Columbia-University-ZMBBI-AIC/Teenscience/README.md

# TeenScience
TennScience Platform
TennScience is a hardware and software platform based in Arduino and Teensy 3.6 for science research involving behavioral neuroscience, robotics, sound analysis, and more.
Testing Hardware
