Columbia-University-ZMBBI-AIC/Teenscience/editbrd.pptx

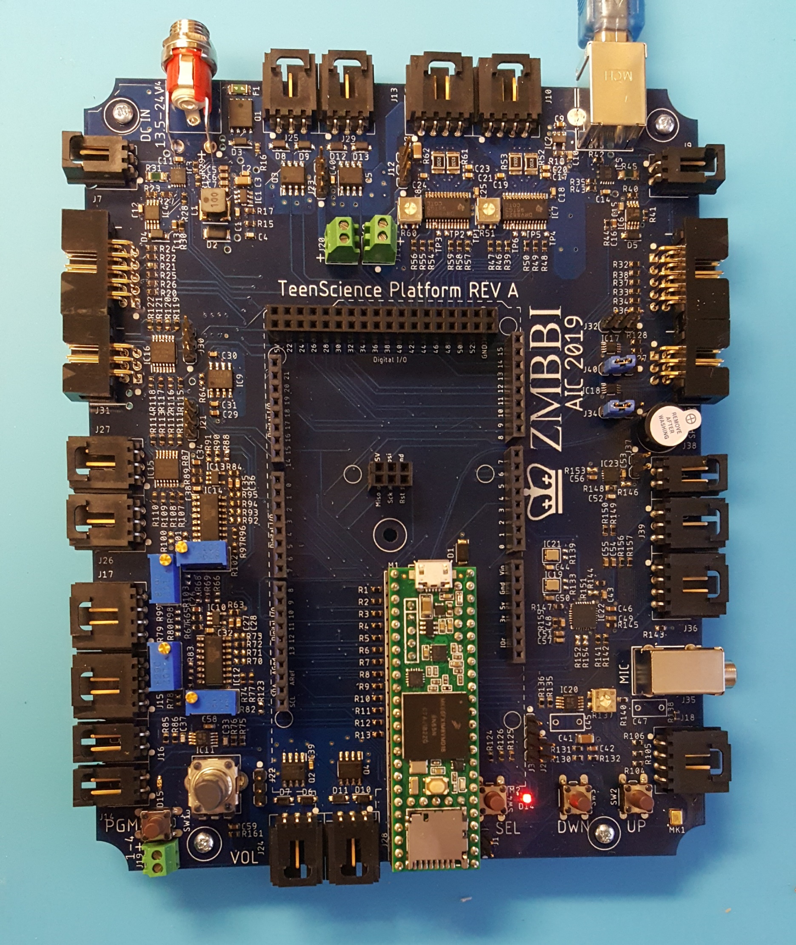
[picture p1: figure]

PWR
J4

GPO
5-6
J25

GPO 5-8
J23

GPO
5-8
J20

GPO
7-8
J29

STPR
LEFT
J13

STPR
J12

STPR
J11

STPR
RIGHT
J10

USB
J5

DC M
LEFT
J7

DC M
RIGHT
J9

ENC
LEFT
J6

GP LEV
J32

ENC
RIGHT
J8

GPIO
J33

S4-SPI
J31

I2C
1
J27

I2C 0/1
J21

SPI LEV
J30

GP I/O
J34

GP I/O
J40

INT.SPK
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
DEB. J3

3.3V J2

TOUCH
J18

DAC
1
J14

POT/VOL

GPO 1-4
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
BATT J1
