Columbia-University-ZMBBI-AIC/Teenscience/Mechanical/TeenSciencePalformPCB-REVB.jpg

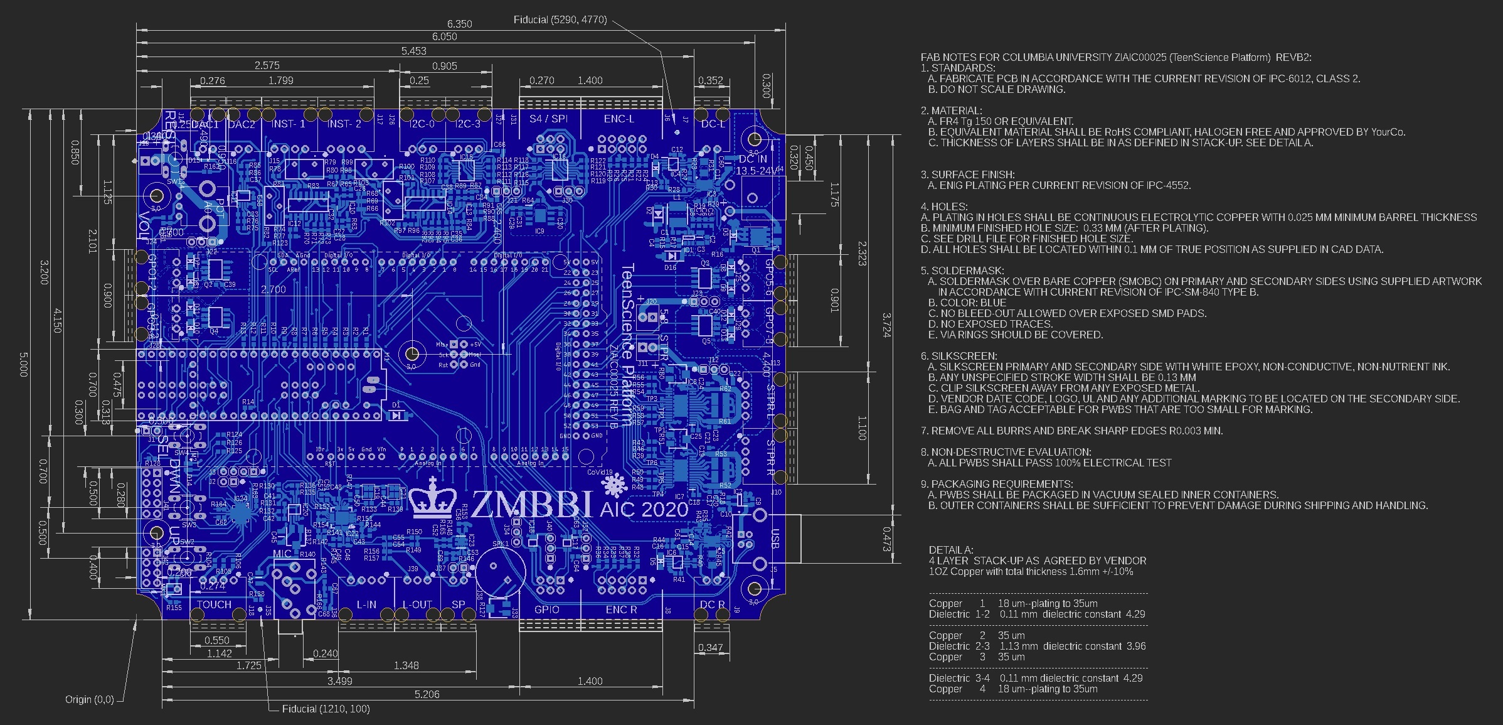
Mechanical/TeenSciencePalformPCB-REVB.jpg
