Columbia-University-ZMBBI-AIC/Teenscience/Hardware/TeenScience-RevB5-SCHB4.BOM.xlsx

 | Columbia University TeenScience Platform ZIAIC00025 REVB4- May 2020 | Rev by R. Hormigo
Qty | DESCRIPTION | Value | Package | Parts | MNF | MPN | VENDOR | Column1
31 | Multilayer Ceramic Capacitor (MLCC)X7R 0603, 0.10uF 5%, 50V | 0.10uF | MLCC_0603 | C1, C2, C11, C12, C14, C15, C17, C19, C20, C21, C23, C24, C28, C30, C31, C32, C36, C38, C39, C40, C43, C44, C48, C53, C58, C62, C63, C64, C65, C66 | AVX | 06035C104JAT2A | Mouser
2 | Multilayer Ceramic Capacitor (MLCC)X7R 0603, 0.010uF 5%, 50V | 0.010uF | MLCC_0603 | C18, C25, C57 | AVX | 06035C103JAT2A | Mouser
6 | Ceramic Capacitor X7R 1206 35V 10uF | 10uF | MLCC_1206 | C3, C22, C45, C47, C60, C61 | TAIYO YUDEN | GMK316AB7106KL-TR
4 | Multilayer Ceramic Capacitor (MLCC)C0G HF 0603, 47pF 1%, 100V | 47pF | MLCC_0603 | C4, C33, C37, C52 | Murata | GCM1885C2A470FA16D | Mouser
15 | Multilayer Ceramic Capacitor (MLCC)X5R 0603, 10uF 10%, 10V | 10uF | MLCC_0603 | C5, C6, C7, C8, C10, C41, C49, C50, C51, C54, C55, C56, C67, C68, C69 | AVX | 0603ZD106KAT2A | Mouser
12 | Multilayer Ceramic Capacitor (MLCC)X7R 0603, 1uF 10%, 35V | 1uF | MLCC_0603 | C9, C13, C16, C26, C27, C29, C34, C35, C42, C46, C59, C70 | TDK | CGA3E1X7R1V105K080AC | Mouser
3 | Nexperia PMEG3030EP,115 SMT Schottky Diode, 30V 3A, 2-Pin SOD128 | PMEG3030 | SOD_128_DIODE | D1, D2, D16 | Nexperia | PMEG3030EP,115
1 | LED DIODE RGB, 5mA, SMT 2X2X0.9mm | RGB | SON95P2X2X1-RGB_LED | D14 | Cree | CLMVC-FKA-CLBDGL7LBB79353 | Mouser
1 | LED DIODE Green, 2mA, 1.9V, SMT 0603 | Green | LED_0603 | D15 | Kingbright | APTD1608LCGCK | Mouser
1 | ZENNER DIODE, 0.5W, 9.1V, SMT SOD123-2 | 9.1V | SOD3716X135N_DIODE | D3 | ON Semi | MMSZ9V1T1G | Mouser
2 | Low forward voltaage Schottky diode | PMEG2010 | SOD-123FL | D4, D5 | Nexperia | PMEG2010ER,115
8 | Rectifier Diode 2A 200V. SOD−123FL | NHP220 | SOD-123FL | D6, D7, D8, D9, D10, D11, D12, D13 | ON Semi | NHP220SFT3G | Mouser
1 | 3A Fast Fuse 1206-3.2X1.6MM | F3A | 1206-3.2X1.6MM | F1 | Schurter | 3413.0121.24
1 | Switching Voltage Regulators DCDC Conv HV Buck TSOT26 | AP63200 | SOT95P280X100-6N | IC1 | Diodes Inc. | AP63200WU-7 | Mouser
2 | 10MHz, IO Rail-to-Rail Op Amp, 12V 2mA max, high current out, SOT-23 | LT1797 | SOT23-5 | IC10, IC13 | LinearTechnologies | LT1797CS5#TRMPBF | Mouser
2 | INA125U, Instrumention Amplifier, 0.25mV Offset, 78dB CMRR, 5V, 16-Pin SOIC | INA125 | SOIC16-127P600X175 | IC12, IC14 | Texas Instruments | INA125U
2 | 4-Bit Bidirectional Multi-Voltage Level Translator for Open-Drain & Push- Pull | LSF0204 | TSSOP14 | IC15, IC16 | Texas Instruments | LSF0204PWR
2 | Texas Instruments SN74LVC2T45DCUR, Voltage Level Translator, Bus Transceiver, 3-State, 1.65 5.5 V, 8-Pin UM | 74LVC2T45 | VSSOP8-DCU-050P | IC17, IC18 | Texas Instruments | SN74LVC2T45DCUR
1 | IC Oscillator 1.6 to 3.6V 50PPM 24.576MHz. 2.5 X 2mm | 24.576MHz | 2.5X2-4-PAD | IC19 | Epson | SG-210STF 24.5760ML3 | Mouser
1 | LTC4411CS8 battery/mains PS controller LTC4411ES5#TRMPBF, Battery Charge Controller, 2600mA, 5-Pin SOT-23 | LTC4411 | SOT95P280X100-5N | IC2 | Linear Technology | LTC4411ES5#TRMPBF
1 | IC Oscillator 1.6 to 3.6V 50PPM 11.2896MHz. 2.5 X 2mm | 11.2896MHz | 2.5X2-4-PAD | IC21 | Epson | SG-210STF 11.2896ML3 | Mouser
1 | Audio Codec 108dB 216KHz 32bit 3.3V with PLL. QFN28 | AK4558EN | QFN-28-5MM-0.5P-PAD | IC22 | AKM | AK4558EN | Digikey
1 | Audio Amplifier ClassAB 1.5W 8Ohm with 4MHz GBP. LFCSP-8 | SSM2211 | LFCSP8_3X3 | IC23 | Analog Devices | SSM2211CPZ-REEL7 | Mouser
1 | Interface - I/O Expanders 16 CHAN LOW VOLT I2C GPIO +PWM | SX1509 | QFN-28-4MM-0.4P-PAD | IC24 | SEMTECH | SX1509BIULTRT
2 | DC Motor H Bridge Driver 4.5 to 36V, 2.5A max SMT TDFN-EP 12 3X3mm | MAX14870 | TDFN12-EP | IC3, IC5 | Maxim | MAX14870ETC+T | Mouser
4 | 36-V, Single-Supply, 10-MHz, Rail-to-Rail Output, Dual Operational Amplifier | TLV2172 | VSSOP8-DGK-065P | IC4, IC6, IC11, IC20 | Texas Instruments | TLV2172IDGKR
2 | 2.5A Bipolar Stepper Motor Driver with On-Chip 1/32 Microstepping Indexer (Step/Dir Ctrl) | DRV8825PWPR | TSSOP28-PWR | IC7, IC8 | Texas Instruments | DRV8825PWPR
1 | ROHM BDJ2FC0WEFJ-E2 LDO HTSOP 8 | BDJ2FC0 | SOIC8-PAD127P600X100 | IC9 | ROHM Semi | BDJ2FC0WEFJ-E2
3 | Header Straight Male 1 X 2 (2.54mm square) 6.75mm post | HDR 1x2 ST-M | HDR_1X2 | J1, J2, J37 | Amphenol FCI | 77311-124-02LF | Mouser
6 | Header RA Male 1X4 Gold Shrouded 0.1" | HDR 1X4 RA-M | HDR_1X4RAS | J10, J13, J15, J17, J18, J36 | Molex | 70555-0073 | Mouser
3 | Phenix Screw terminal 0.1" X 2 | Phoenix 1X2 | TE_282834-2_PHOENIX2 | J11, J19, J20 | TE | 282834-2 | Mouser
8 | Header Straight Male 1 X 3 (2.54mm square) 6.75mm post | HDR 1x3 ST-M | HDR_1X3 | J12, J21, J22, J23, J30, J32, J34, J40 | Amphenol FCI | 77311-124-03LF | Mouser
7 | Header RA Male 1X3 Gold Shrouded 0.1" | HDR 1X3 RA-M | HDR_1X3RAS | J24, J25, J26, J27, J28, J29, J39 | Molex | 70555-0072 | Mouser
1 | Header Straight Male 1 X 4 (2.54mm square) 6.75mm post | HDR 1x4 ST-M | HDR_1X04 | J3 | Amphenol FCI | 77311-124-04LF | Mouser
2 | Header RA Male 2X3 Gold Shrouded 0.1" | HDR 2X3 RA-M | HDR_2X3M_RAS | J31, J33 | 3M | 30306-5002HB | Mouser
1 | Phone Connectors 3.5mm Audio Jack Stereo with Switch | JACK 3.5mm | AUDIO-JACK-SJ1-3533NS | J35 | CUI | SJ1-3535NS
1 | DC Power Jack, Panel Mount, 2.1mm, Standard Bushing, Right Angle PC | 2.1 ID | DCJACK-721RA | J4 | Switchcraft | 721RA
1 | Header Right Angle 2 X 5 (2.54mm square) 5.84 mm mating | HDR 2x5 RA-M | HDR_2X5M_RAHDR | J41 | SAMTEC | TSW-104-10-G-D-RA | Mouser
1 | Header Right Angle 2 X 4 (2.54mm square) 5.84 mm mating | HDR 2x4 RA-M | HDR_2X4M_RAHDR | J42 | SAMTEC | TSW-104-08-G-D-RA | Mouser
1 | USB B STANDARD RA, TH | USB-B-RA | USB-B | J5 | MOLEX | 67068-8000 | Mouser
2 | Header RA Male 2X5 Gold Shrouded 0.1" | HDR 2X5 RA-M | HDR_2X5M_RAS | J6, J8 | 3M | 30310-5002HB | Mouser
5 | Header RA Male 1X2 Gold Shrouded 0.1" | HDR 1X2 RA-M | HDR_1X2RAS | J7, J9, J14, J16, J38 | Molex | 70555-0071 | Mouser
1 | TDK VLS-EX Series Type 5045 Shielded Wire-wound SMD Inductor with a Ferrite Core, 10 uH Wire-Wound 2.5A Idc | 10uH | IND_5X5MM-5045 | L1 | TDK | VLS5045EX-100M
1 | Teensy 3.6, 3.3V, 180MHz controller with no pins | Teensy 3.6 | TEENSY_3.6 | M1 | PJRC | TEENSY36 (No pins) | Sparkfun
1 | Teensy 3.5/3.6 Socket Kit | Connector Kit | See datasheet directions | M1 (Pins) | Tall Dog Electronics | Teensy 3.5/3.6 Socket Kit | Tindie.com | https://d3s5r33r268y59.cloudfront.net/datasheets/8746/2017-02-08-07-39-59/Teensy_3.5_3.6_Socket_Kit_Datasheet.pdf
1 | Wideband 80KHz MEMS 2.65X3.5mm MIC 400Ohm 145uA 1.5-3.6V | MIC | SPH6611_MEMS_2.65X3.50 | MK1 | KnowLess | SPH6611LR5H-1 | Mouser
1 | P CH MOSFET 40V, 100A, 1.4mOhm, SMT DFN 8 5.1x6.3 | FDWS9509L | FDN8_5.1X6.3 | Q1 | ON Semi | FDWS9509L-F085 | Mouser
4 | Diodes Inc DMG4822SSDQ-13 Dual N-channel MOSFET Transistor, 10 A, 30 V, 8-Pin SOP | DMG4822 | SOIC8-127P60 | Q2, Q3, Q4, Q5 | Diodes Inc. | DMG4822SSDQ-13
19 | Thick Film Resistor 0603, 20 Ω ,1%, 0.1W | 20 Ω | R0603 | R1, R2, R3, R4, R5, R6, R7, R8, R9, R10, R11, R12, R13, R14, R63, R84, R144, R145, R161 | Vishay | CRCW060320R0FKEA | Mouser
7 | Thick Film Resistor 0603, 1.0 kΩ ,1%, 0.1W | 1.0 kΩ | R0603 | R104, R105, R106, R111, R112, R113, R114 | Vishay | CRCW06031K00FKEA | Mouser
2 | Thick Film Resistor 0603, 360 Ω ,1%, 0.1W | 360 Ω | R0603 | R123, R124 | Vishay | CRCW0603360RFKEA | Mouser
5 | Thick Film Resistor 0603, 100 Ω ,1%, 0.1W | 100 Ω | R0603 | R125, R126, R138, R156, R157 | Vishay | CRCW0603100RFKEA | Mouser
1 | SM Single turn Top Screw Trimmer 1K | 1K | SM-4.5X4.5-TRIM | R127 | BOURNS | 3314J-2-102E
11 | 0603 Resistor Shunt (no part placed) | SHUNT | R0603-SHORT | R129, R146, R151, R152, R153, R154, R158, R159, R160, R163, R164
1 | Audio single pot. 10K Vertical 20mm,1B Alps Potentiometer RK09D Series with a 6 mm Dia. Shaft 10k +/-20% 0.05W, Linear, Through Hole | 10K | RK09-ALPS-VERT-POT | R134 | ALPS | RK09D1130C1B
1 | SM Single turn Top Screw Trimmer 200K | 200K | SM-4.5X4.5-TRIM | R137 | BOURNS | 3314J-2-204E
1 | Thick Film Resistor 0603, 56 kΩ ,1%, 0.1W | 56 kΩ | R0603 | R15 | Vishay | CRCW060356K0FKEA | Mouser
1 | Thick Film Resistor 0603, 100 kΩ ,1%, 0.1W | 100 kΩ | R0603 | R16 | Vishay | CRCW0603100KFKEA | Mouser
44 | Thick Film Resistor 0603, 10 kΩ ,1%, 0.1W | 10 kΩ | R0603 | R17, R19, R27, R28, R29, R30, R35, R39, R41, R42, R43, R44, R47, R48, R49, R50, R54, R56, R57, R58, R59, R67, R76, R86, R89, R107, R108, R109, R110, R115, R116, R117, R118, R119, R120, R121, R122, R128, R131, R132, R140, R149, R150, R162 | Vishay | CRCW060310K0FKEA | Mouser
1 | Thick Film Resistor 0603, 470 kΩ ,1%, 0.1W | 470 kΩ | R0603 | R18 | Vishay | CRCW0603470KFKEA | Mouser
10 | Thick Film Resistor 0603, 2.2 kΩ ,1%, 0.1W | 2.2 kΩ | R0603 | R20, R21, R22, R32, R33, R34, R74, R96, R143, R166 | Vishay | CRCW06032K20FKEA | Mouser
3 | Thick Film Resistor 0603, 300 kΩ ,1%, 0.1W | 300 kΩ | R0603 | R23, R40, R135 | Vishay | CRCW0603300KFKEA | Mouser
8 | Thick Film Resistor 0603, 4.3 kΩ ,1%, 0.1W | 4.3 kΩ | R0603 | R24, R25, R26, R36, R37, R38, R65, R136 | Vishay | CRCW06034K30FKEA | Mouser
2 |  | 0.025 Ohm | R1206 | R31, R45 | KOA | UR73VD2BTTD25L0F
11 | Thick Film Resistor 0603, 0 Ω ,1%, 0.1W | 0 Ω | R0603 | R46, R55, R68, R69, R72, R94, R130, R141, R142, R147, R155 | Vishay | CRCW06030000Z0EA | Mouser
2 | SM Single turn Top Screw Trimmer 10K | 10K | SM-4.5X4.5-TRIM | R51, R60 | BOURNS | 3314J-2-103E
4 |  | 0.1 Ohm | R1210 | R52, R53, R61, R62 | Vishay | RCWE1210R100FKEA
21 | No Placed/Populated Resistor | NP | R0603 | R64, R66, R70, R71, R73, R77, R78, R80, R83, R88, R90, R91, R92, R93, R95, R97, R98, R100, R103, R133, R139
2 | Thick Film Resistor 0603, 3.9 kΩ ,1%, 0.1W | 3.9 kΩ | R0603 | R75, R85 | Vishay | CRCW06033K90FKEA | Mouser
4 | Thru Hole Multiturn Top ScrewTrimmer | 1K | PV36YTRIMMER | R79, R82, R99, R102 | Bourns | PV36Y102C01B00
2 | Thick Film Resistor 0603, 51 Ω ,1%, 0.1W | 51 Ω | R0603 | R81, R101 | Vishay | CRCW060351R0FKEA | Mouser
3 | Thick Film Resistor 0603, 15 kΩ ,1%, 0.1W | 15 kΩ | R0603 | R87, R148, R165 | Vishay | CRCW060315K0FKEA | Mouser
1 | Piezo Transducer 5mm Pitch 12.4mm Diameter. 2KHz Resonance, 5v Nom,30V max | CMI-9650C-120 | BUZZER-5MM-12.4D | SPK1 | DB LIMITED | TP124005-2
4 | Momentary Switch 6mm SPST 100mOhm Max 50ma 12V | SPST | SWITCH_TAC_6MM | SW1, SW2, SW3, SW4 | Diptronics | DTS-65N-V | Mouser
2 | 24.5x3mm | LED Light Pipes LFB 3mm LightPipe 1.000" Length | EXTERNAL | LP1, LP2 | VCC | LFB100CTP | Mouser
