Columbia-University-ZMBBI-AIC/Teenscience/TeenScienceRAVA0-SignalsReleased.xlsx

TeenScience REV A Hardware platform pinouts and signals for Teensy 3.6
Description | TeenScience Connector-Pin | TeenScience | Teensy Pin Used | Other Teensy Functionality | Settings
Ext. Battery | J1-1 | GND | GND | GND
 | J1-2 | VBATT |  | VBATT
V3.3V | J2-1 | GND | GND | GND
 | J2-2 | 3.3V OUT |  | 3.3V OUT
Debug Port | J3-1 |  |  | Debug Reset
 | J3-2 |  |  | DC
 | J3-3 |  |  | DD
 | J3-4 |  |  | DE
DC Power IN VPWR 13.5-24V | J4-Center | DC VPWR
 | J4-Shield | GND | GND | GND
USB IF | J5-1 | USB RAW 5V
 | J5-2 | USB+ |  | USB+
 | J5-3 | USB- |  | USB-
 | J5-4 | GND | GND | GND
 | J5-Shield | GND | GND | GND
Encoder Left | J6-1 | NC
 | J6-2 | +5V
 | J6-3 | GND | GND
 | J6-4 | NC
 | J6-5 | NC
 | J6-6 | CHA-L | D3 (I) | SCL-2/CAN0TX/PWM
 | J6-7 | NC
 | J6-8 | CHB-L | D4 (I) | SDA-2/CAN0RX/PWM
 | J6-9 | NC
 | J6-10 | CHI-L | D2 (I) | PWM
DC Motor Left | J7-1 | M1-L | D26 - ~FAULT (I) D7 - DIR (O) D5 - PWM (O) D24 - ~EN (O) A14 - CURRENT(O) | RX3/PWM PWM D33/CAN1TX/TX5
 | J7-2 | M2-L
Encoder Right | J8-1 | NC
 | J8-2 | +5V
 | J8-3 | GND | GND
 | J8-4 | NC
 | J8-5 | NC
 | J8-6 | CHA-R | D29 (I) | Touch@29/PWM
 | J8-7 | NC
 | J8-8 | CHB-R | D30 (I) | Touch@30/PWM
 | J8-9 | NC
 | J8-10 | CHI-R | D28 (I)
DC Motor Right | J9-1 | M1-R | D27 - ~FAULT (I) D8 - DIR (O) D6 - PWM (O) D25 - ~EN (O) A15 - CURRENT(O) | TX3/PWM PWM D34/CAN1RX/RX5
 | J9-2 | M2-R
Stepper PWR (EXT PWR for Steppers) | J11-1 | GND |  |  | Use J12 to select either EXT PWR@J11 (1-2) or internal VPWR (2-3) for steppers
 | J11-2 | EXT PWR
Stepper Right | J10-1 | B1-R | D49 - DIR (O) D50 - STEP (O) D48 - ~FAULT/~SLEEP (I/O) D47 - ~RESET (O) D53 - MODE2 (I) D52 - MODE1 (I) D51 - MODE0 (I) | A23 A24 TX6 RX6 Shared with Left Shared with Left Shared with Left
 | J10-2 | B2-R
 | J10-3 | A1-R
 | J10-4 | A2-R
Stepper Left | J13-1 | B1-L | D45 - DIR (O) D46 - STEP (O) D44 - ~FAULT/~SLEEP (I/O) D43 - ~RESET (O) D53 - MODE2 (I) D52 - MODE1 (I) D51 - MODE0 (I) | MISO2 SCK2 MOSI2 CS2 Shared with Right Shared with Right Shared with Right
 | J13-2 | B2-L
 | J13-3 | A1-L
 | J13-4 | A2-L
DAC 1 | J14-1 | AGND | AGND | GND
 | J14-2 | DAC1 | DAC0 | A21
Inst. Amp. 1 | J15-1 | VREF1 (AGND) | A6 AGND | D20 PWM CS0 GND
 | J15-2 | -VIN1
 | J15-3 | +VIN1
 | J15-4 | VREF1 (O)
DAC 2 | J16-1 | AGND | AGND | GND
 | J16-2 | DAC1 | DAC0 | A21
Inst. Amp. 2 | J17-1 | VREF2 (AGND) | A6 AGND | D20 PWM CS0 GND
 | J17-2 | -VIN2
 | J17-3 | +VIN2
 | J17-4 | VREF2 (O)
Touch Interface | J18-1 | AGND | GND | GND
 | J18-2 | TOUCH1/UP_SW | Touch@17 | A3/PWN
 | J18-3 | TOUCH2 | Touch@16 | A2/PWM
 | J18-4 | TOUCH3 | Touch@15 | A1/CS0
GPO 1-4 PWR (EXT PWR for GPOs) | J19-1 | GND |  |  | Use J22 to select either EXT PWR@J19 (1-2) or internal VPWR (2-3) for GPO 1-4
 | J19-2 | EXT PWR 1-4
GPO 1-2 | J24-1 | GPO 1 | D35 | A16/PWM
 | J24-2 | PWR 1-4
 | J24-3 | GPO 2 | D36 | A17/PWM
GPO 3-4 | J28-1 | GPO 3 | D39 | A20
 | J28-2 | PWR 1-4
 | J28-3 | GPO 4 | D40
GPO 5-8 PWR (EXT PWR for GPOs) | J20-1 | GND |  |  | Use J23 to select either EXT PWR@J20 (1-2) or internal VPWR (2-3) for GPO 5-8
 | J20-2 | EXT PWR 5-8
GPO 5-6 | J24-1 | GPO 5 | D37 | A18/PWM/SCL1
 | J24-2 | PWR 5-8
 | J24-3 | GPO 6 | D38 | A19/PWM/SDA1
GPO 7-8 | J28-1 | GPO 7 | D41
 | J28-2 | PWR 5-8
 | J28-3 | GPO 8 | D42
GPIO/BUZZER | J33-1 | INT. BUZZER+/GPIO10 | D10 (I/O) | CS0/TX2 | Use J32 to select either +5V (1-2) or 3.3V (2-3) level for all J33 levels
 | J33-2 | INT. BUZZER-/GPIO12 | D12 (I/O) | MISO0
 | J33-3 | EXT. BUZZER+/GPIO54 | D54 (I/O) | CS2 | Use J34 to select GPIO direction In(1-2) or Out (2-3) for GPIO10 and GPIO12
 | J33-4 | EXT. BUZZER-/GPIO55 | D55 (I/O)
 | J33-5 | REF PWR |  |  | Use J36 to select either +5V (1-2) or 3.3V (2-3) level for GPIO54 and GPIO55
 | J33-6 | GND | GND
I2C-0 (Main I2C) | J26-1 | GND | GND | GND | Use J21 to select either +5V (1-2) or 3.3V (2-3) level for I2C-0
 | J26-2 | SDA | SDA0 | 19/A5/Touch
 | J26-3 | SCL | SCL0 | 18/A4/Touch
I2C-3 (I2C 3) | J27-1 | GND | GND | GND | Use J21 to select either +5V (1-2) or 3.3V (2-3) level for I2C-0
 | J27-2 | SDA3 | SDA3 | 57
 | J27-3 | SCL3 | SCL3 | 56
SPI-1 /Serial 4 | J31-1 | MISO 1 | MISO1 | D1
 | J31-2 | SPI-PWR |  |  | Use J30 to select either +5V (1-2) or 3.3V (2-3) level for SPI-1
 | J31-3 | SCK 1/TX4 | SCK1/TX4 | D32/A13
 | J31-4 | MOSI 1 | MOSI1 | D0
 | J31-5 | CS 1/RX4 | CS1/RX4 | D31/A12
 | J31-6 | GND | GND | GND
EXT. MIC | J35-TIP | MIC-IN | I2S-MCK I2S-BCK I2S-LRCK I2S-SDO I2S-SDI SCL SDA | D11/MOSI0 D9/RX2/CS0 D23/A9/PWM/Touch D22/A8/PWM/Touch D13/SCK0/LED D19/A5/SCL0/Touch D18/A4/SDA0/Touch | All Audio Ports share the same I2S interface and I2C 0 The I2S can be set via I2C 0 to master or slave. In master the MCK can be set by placing resistors at R133 or R139 for whatever samplings are needed
 | J35-RING | 5V BIAS
 | J35-SHIELD | GND
LINE IN | J36-1 | 3.3V OUT
 | J36-2 | GND
 | J36-3 | Line Left In
 | J36-4 | Line Right In
AMP OUT | J37-1/J38-1 | AMP-
 | J37-2/J38-2 | AMP+
LINE OUT | J39-1 | Line Left Out
 | J39-2 | GND
 | J39-3 | Line Left In
