Columbia-University-ZMBBI-AIC/Teenscience/Mechanical/potM.stl

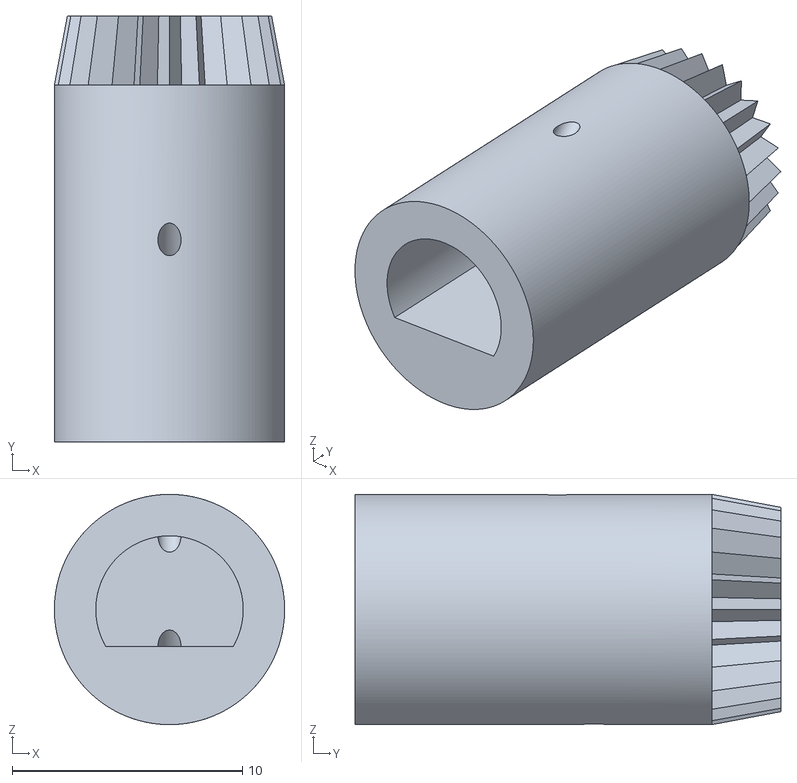
[picture p3: CAD file, 2023-01-09]
Mechanical/potM.stl
10.0 x 18.5 x 10.00
