Columbia-University-ZMBBI-AIC/Teenscience/Mechanical/ButtonPGMTeenScienceM.stl

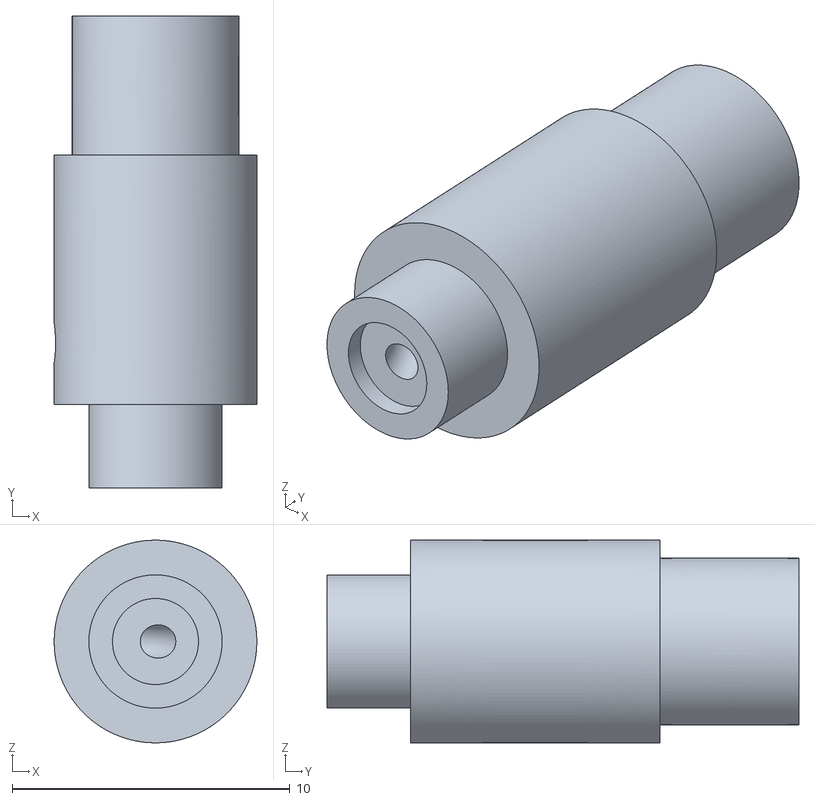
[picture p4: CAD file, 2023-01-09]
Mechanical/ButtonPGMTeenScienceM.stl
7.30 x 17.0 x 7.30
