Columbia-University-ZMBBI-AIC/Teenscience/Mechanical/buttonTeenScienceM.stl

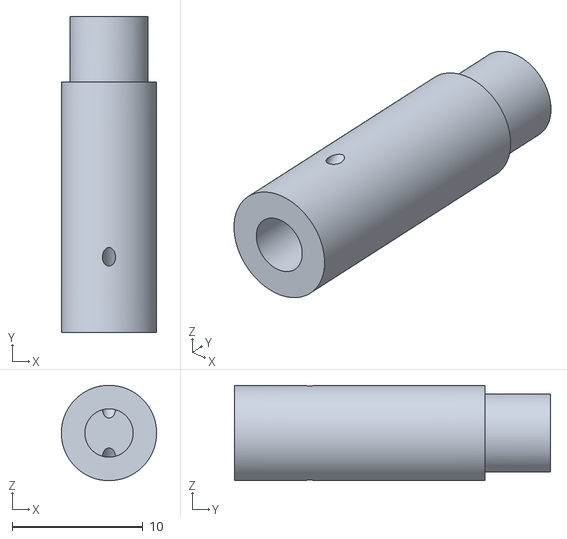
[picture p5: CAD file, 2023-01-09]
Mechanical/buttonTeenScienceM.stl
7.30 x 24.2 x 7.30
