Columbia-University-ZMBBI-AIC/Teenscience/Hardware/TeenScience-RevB2.pdf

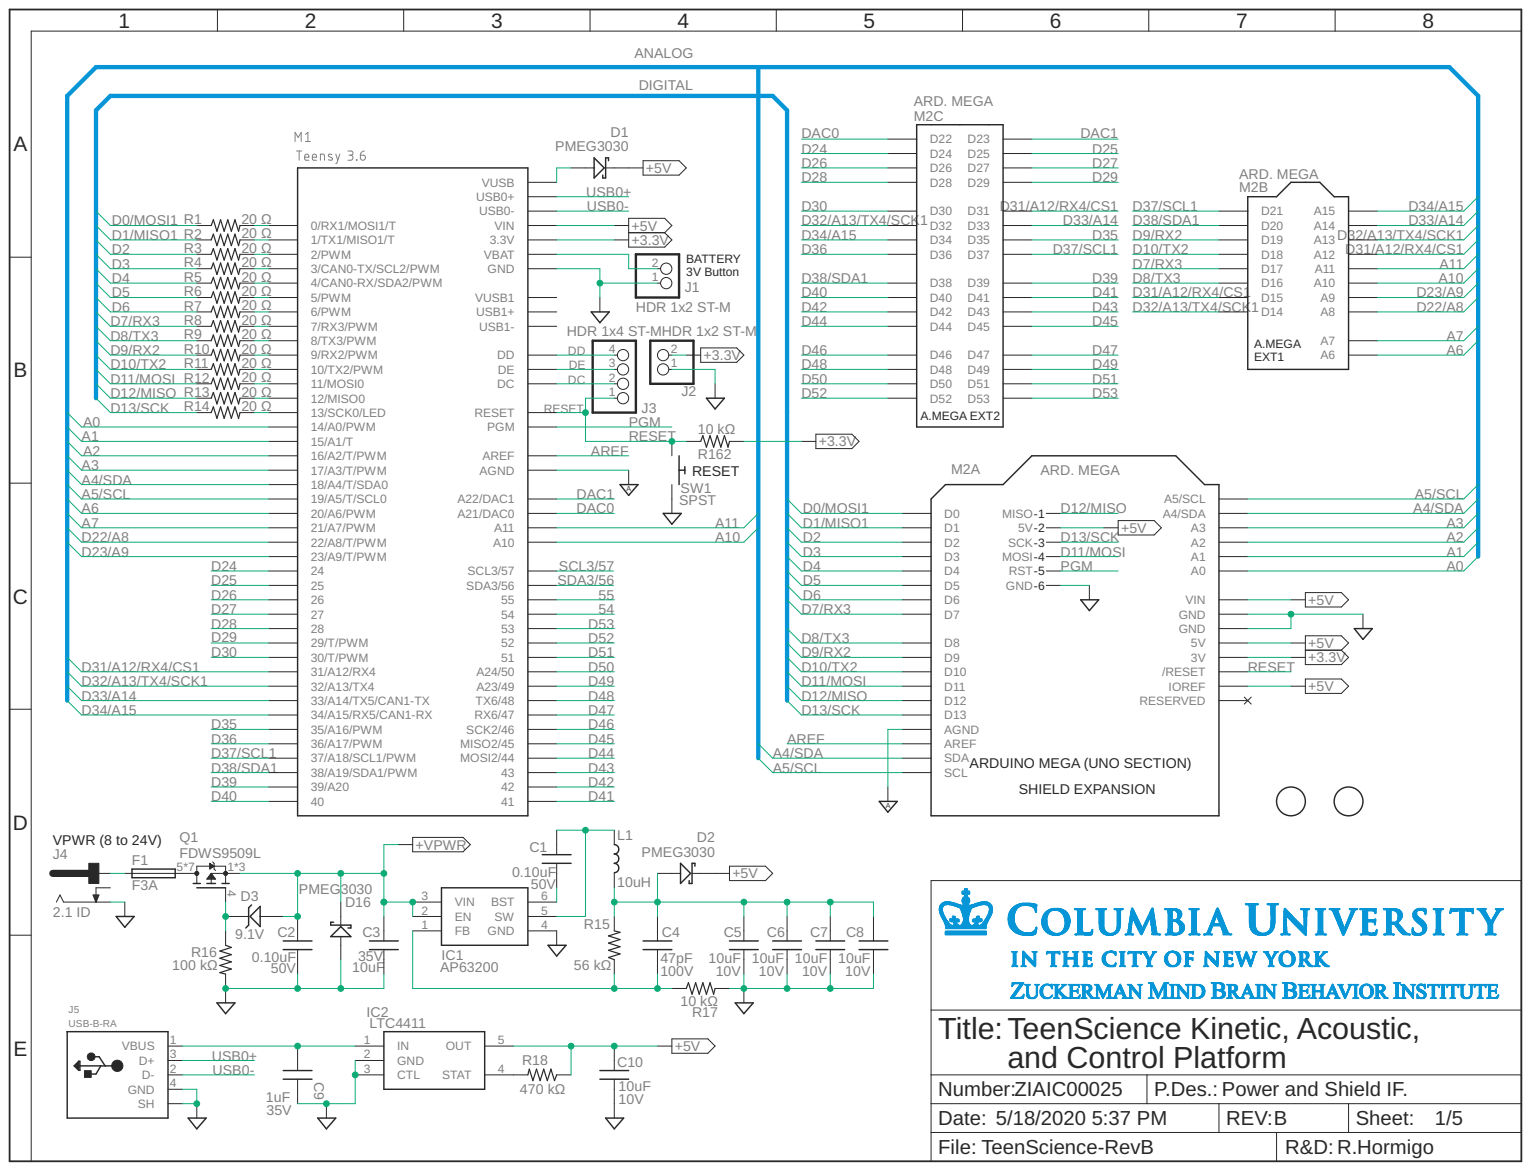
[picture p6: page 1]

ANALOG

HDR 1x4 ST-MHDR 1x2 ST-M
DEDD AREF

TeenScience Kinetic, Acoustic, and Control Platform

Number: ZIAIC00025 | P.Des.:
Date: 5/18/2020 5:37 PM | REV: B | Sheet: 1/5
File: TeenScience-RevB | R&D:

Power and Shield IF. R.Hormigo

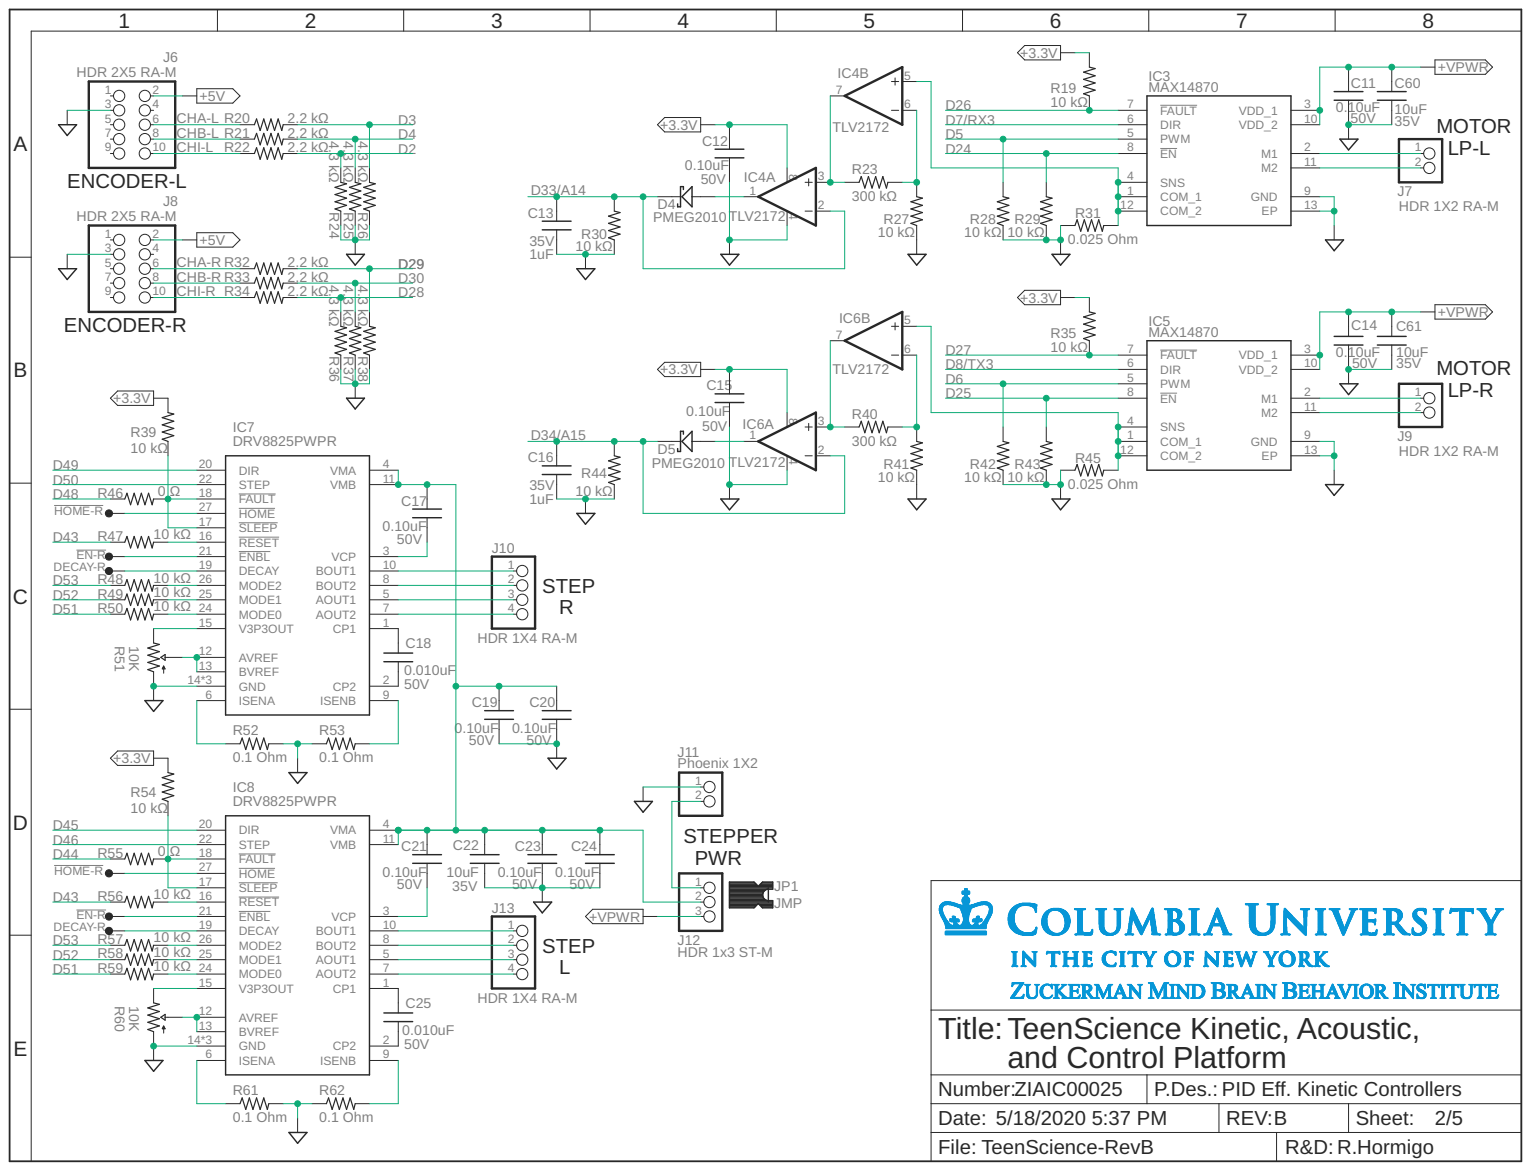
[picture p7: page 2]

TeenScience Kinetic, Acoustic, and Control Platform

PID Eff. Kinetic Controllers

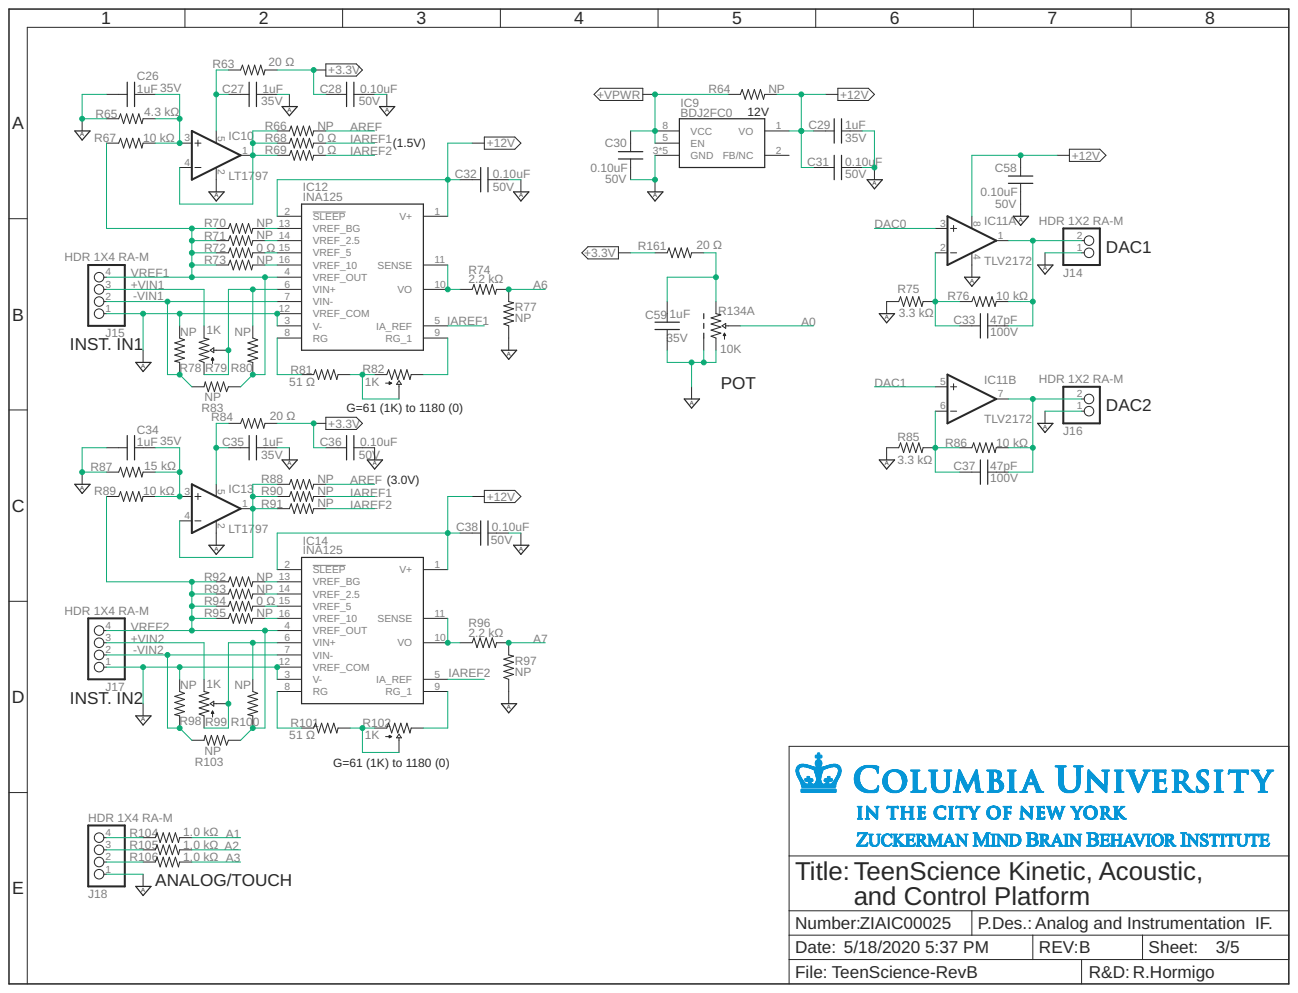
[picture p8: page 3]

TeenScience Kinetic, Acoustic, and Control Platform

Analog and Instrumentation IF. R.Hormigo

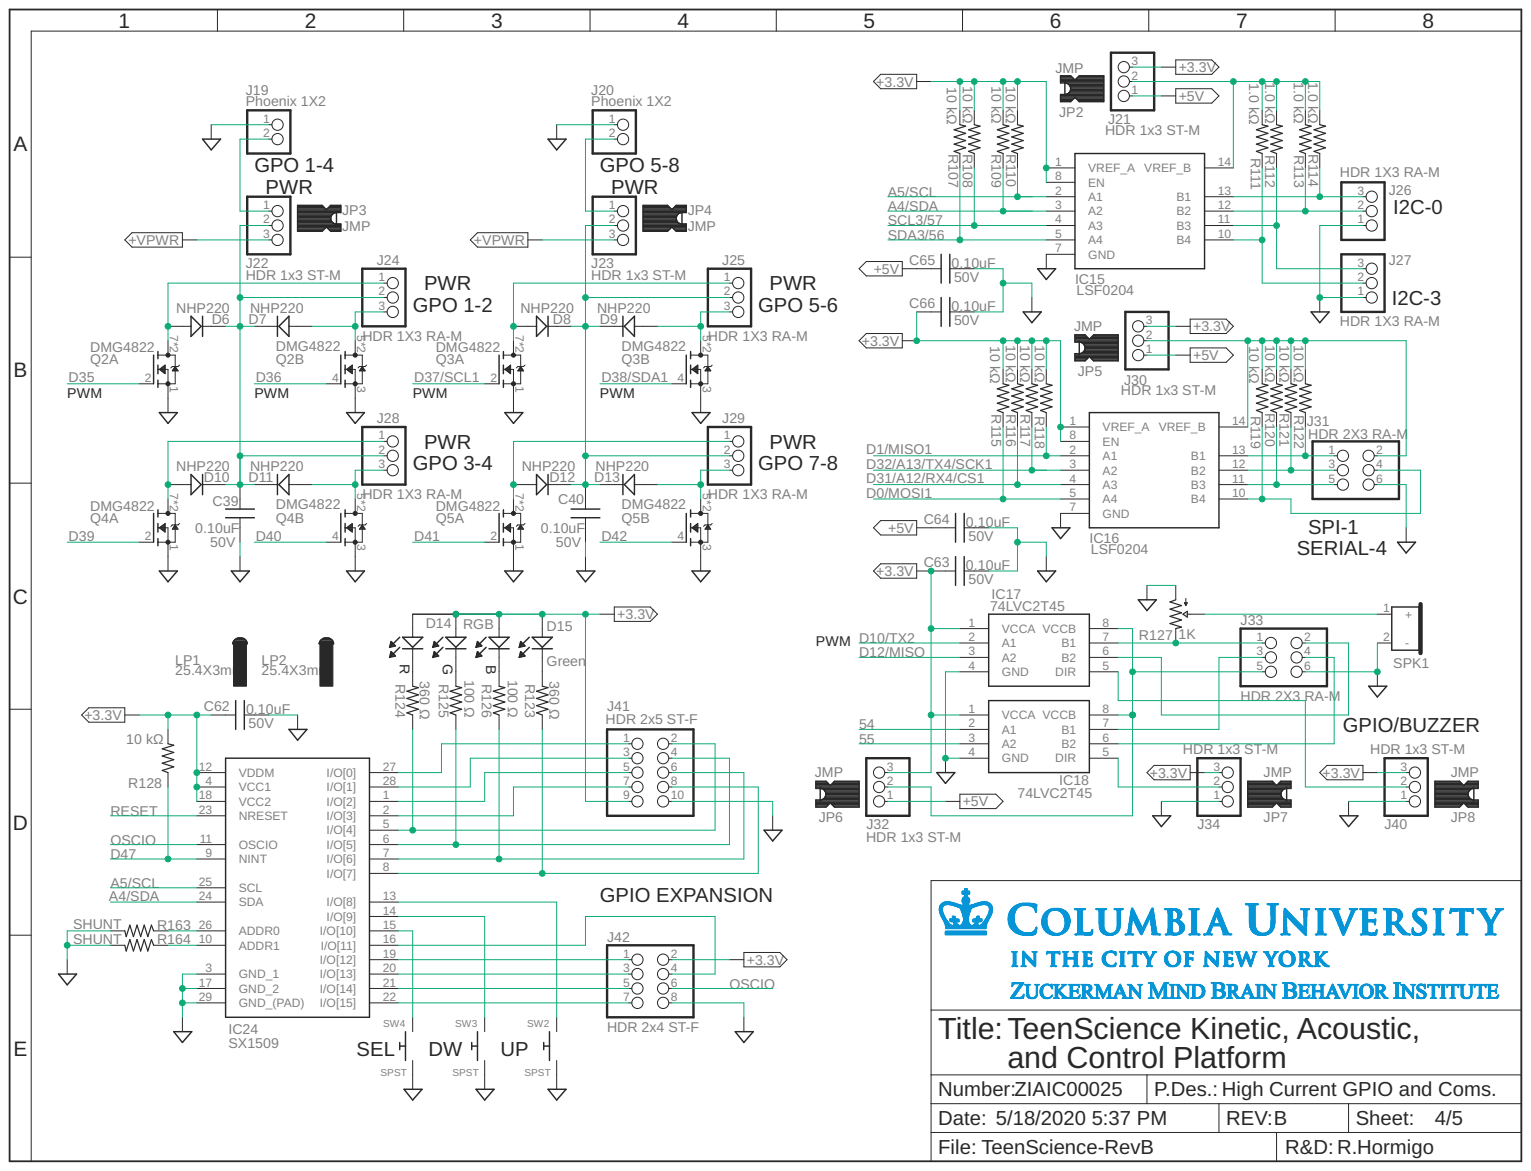
[picture p9: page 4]

TeenScience Kinetic, Acoustic, and Control Platform

High Current GPIO and Coms. R.Hormigo

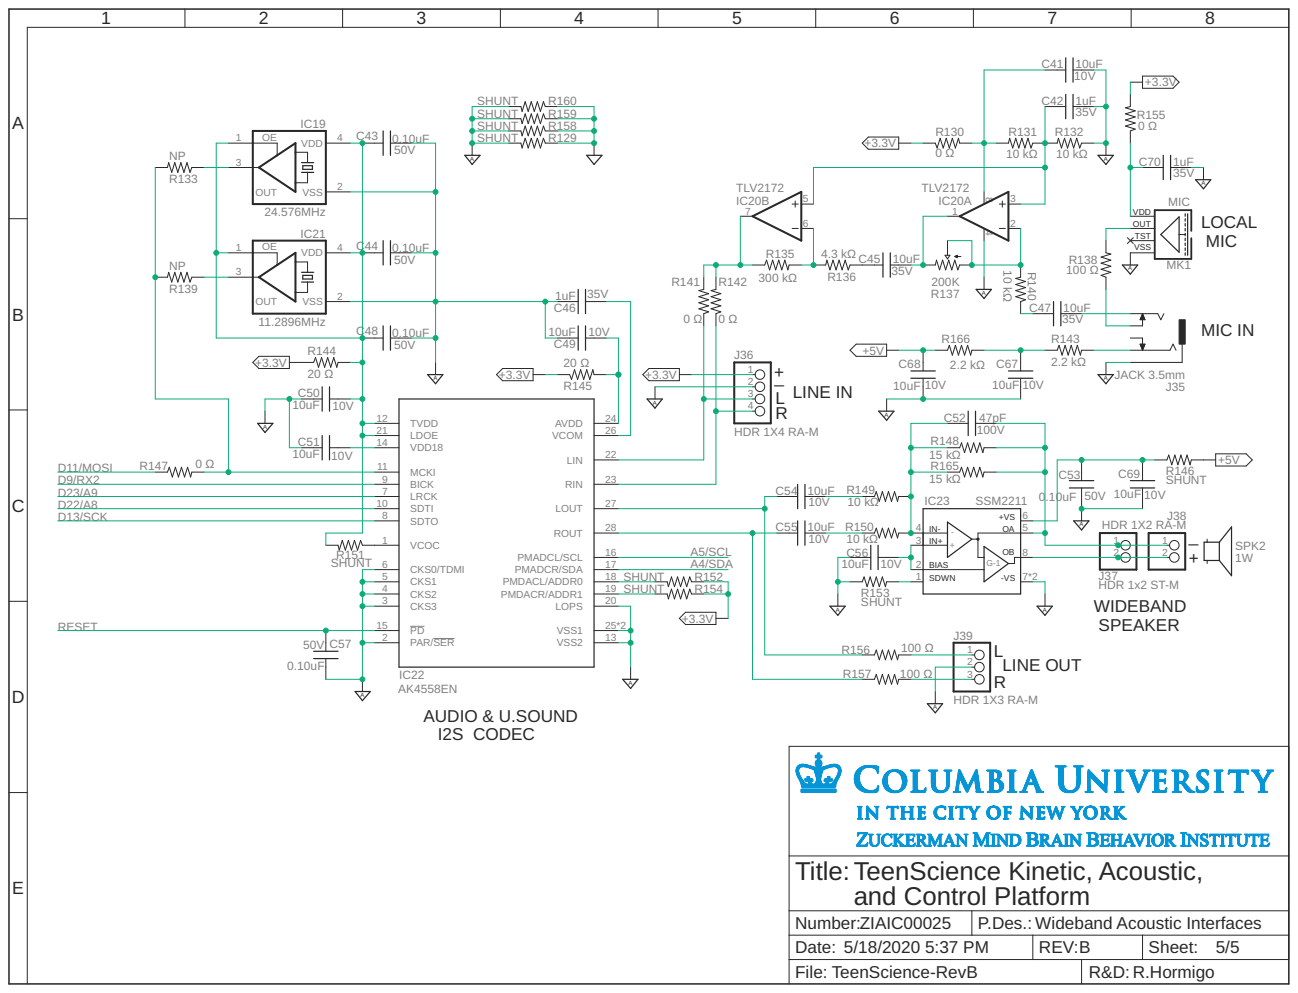
[picture p10: page 5]

TeenScience Kinetic, Acoustic, and Control Platform
