Columbia-University-ZMBBI-AIC/Teenscience/Mechanical/enclosure.pdf

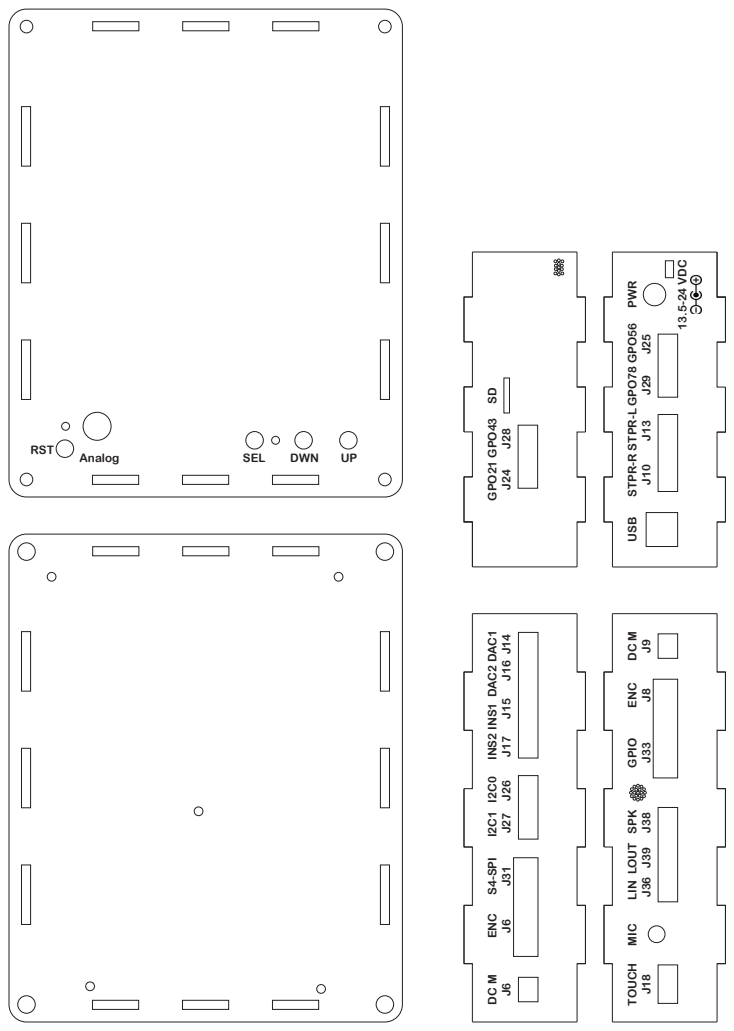
[picture p12: page 1]
