Columbia-University-ZMBBI-AIC/Teenscience/Mechanical/PCB Dim TeenScienceREVA.pdf

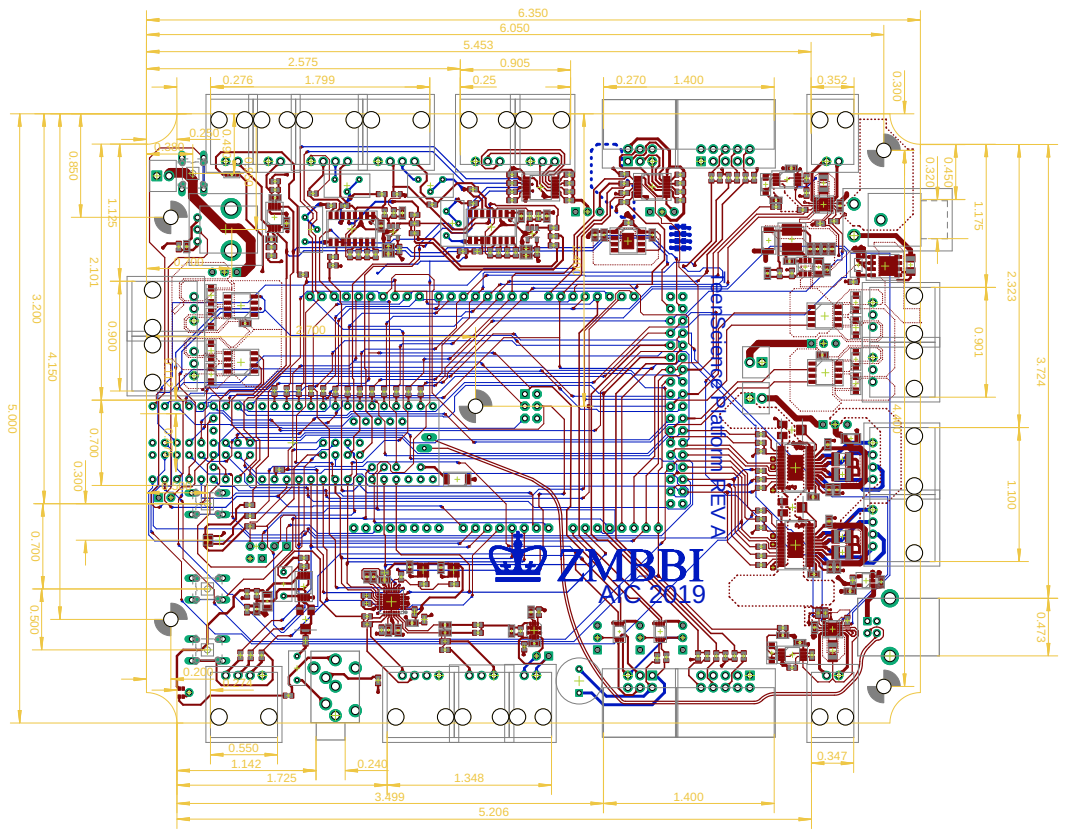
[picture p13: page 1]
