Columbia-University-ZMBBI-AIC/Teenscience/Hardware/TeenScience-RevB3.brd

## EAGLE design Hardware/TeenScience-RevB3.brd (2023-01-09)

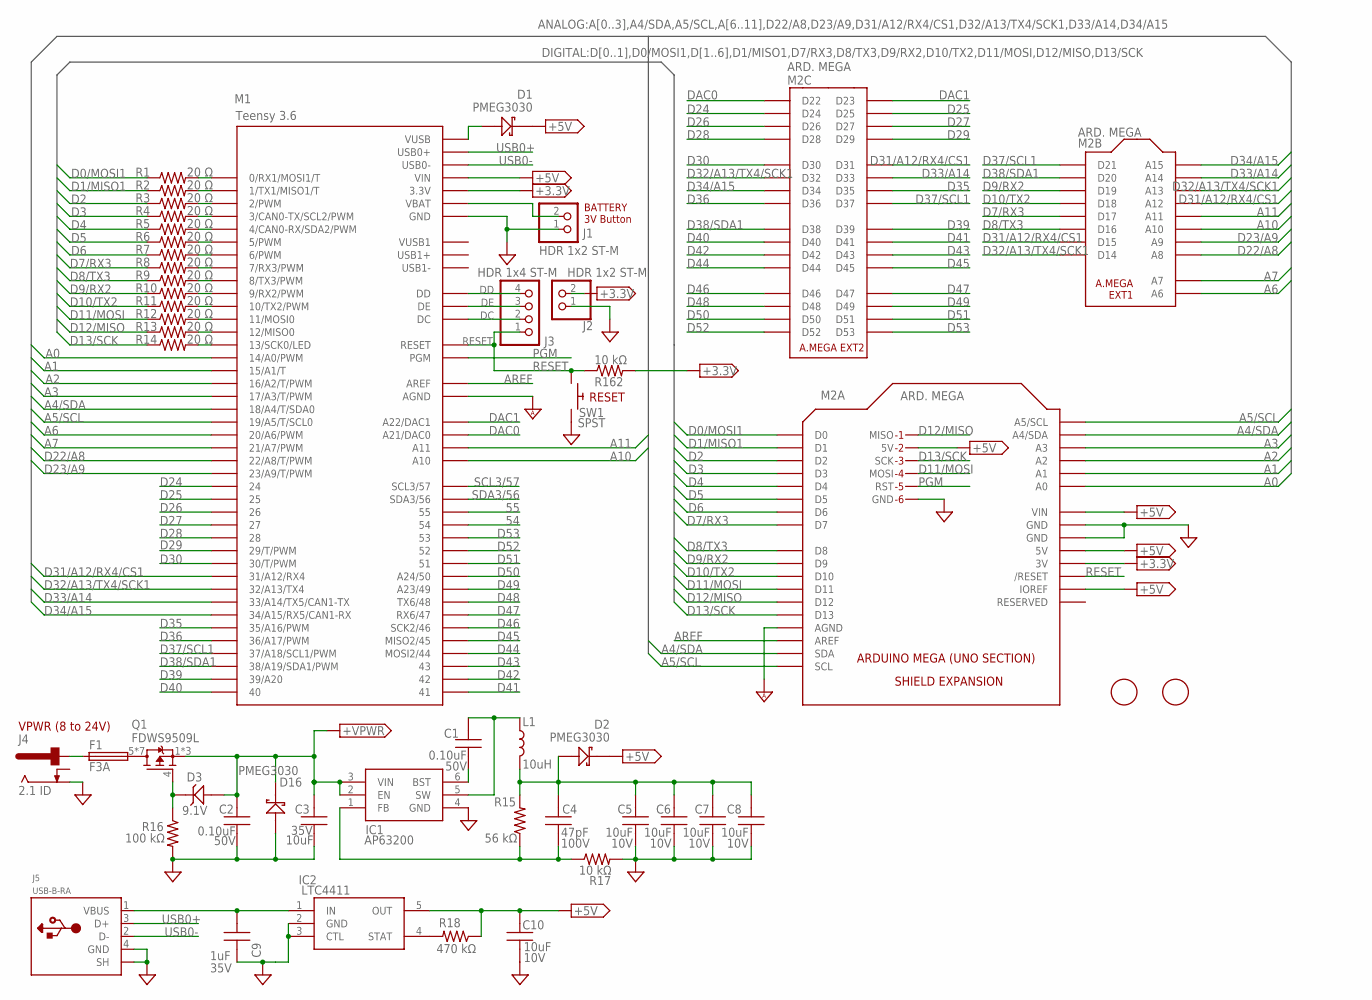
[picture p14: schematic TeenScience-RevB3.sch, sheet 1]

Parts:
C1, C2: 0.10uF; MLCC_0603
C3: 10uF; MLCC_1206
C4: 47pF; MLCC_0603
C5, C6, C7, C8, C10: 10uF; MLCC_0603
C9: 1uF; MLCC_0603
D1, D2, D16: PMEG3030; SOD_128_DIODE
D3: 9.1V; SOD3716X135N_DIODE
F1: F3A; 1206-3.2X1.6MM
IC1: AP63200; SOT95P280X100-6N
IC2: LTC4411; SOT95P280X100-5N
J1, J2: HDR 1x2 ST-M; HDR_1X2
J3: HDR 1x4 ST-M; HDR_1X04
J4: 2.1 ID; DCJACK-721RA
J5: USB-B-RA; USB-B
L1: 10uH; IND_5X5MM-5045
M1: Teensy 3.6; TEENSY_3.6_ALL_PINS&PADS
M2: ARD. MEGA; ARDUINO_MEGA_ICSP
Q1: FDWS9509L; FDN8_5.1X6.3
R1, R2, R3, R4, R5, R6, R7, R8, R9, R10, R11, R12, R13, R14: 20 Ω; R0603
R15: 56 kΩ; R0603
R16: 100 kΩ; R0603
R17, R162: 10 kΩ; R0603
R18: 470 kΩ; R0603
SW1: SPST; SWITCH_TAC_6MM
U$3, U$6: FIDUCIAL; FIDUCIAL_1MM

Connections:
54: M1.54; also elsewhere on the board
55: M1.55; also elsewhere on the board
+3.3V: J2.2, M1.3.3V, M1.3.3V2 (3.3V), M1.3.3V3 (3.3V), M1.3.3V4 (3.3V), M2.3V, R162.2; also elsewhere on the board
+5V: C10.2, D1.1 (K), D2.1 (K), IC2.5 (OUT), M1.VIN, M2.5V, M2.5V@1 (5V), M2.5V@2 (5V), M2.5V_ICSP (5V), M2.IOREF, M2.VIN, R18.1; also elsewhere on the board
+VPWR: C2.1, C3.1, D3.2 (A), D16.1 (K), IC1.2 (EN), IC1.3 (VIN), Q1.1 (S), Q1.2 (S), Q1.3 (S); also elsewhere on the board
A0: M1.14/A0 (14/A0/PWM), M2.A0; also elsewhere on the board
A1: M1.15/A1 (15/A1/T), M2.A1; also elsewhere on the board
A2: M1.16/A2 (16/A2/T/PWM), M2.A2; also elsewhere on the board
A3: M1.17/A3 (17/A3/T/PWM), M2.A3; also elsewhere on the board
A4/SDA: M1.18/A4 (18/A4/T/SDA0), M2.A4 (A4/SDA), M2.SDA; also elsewhere on the board
A5/SCL: M1.19/A5 (19/A5/T/SCL0), M2.A5 (A5/SCL), M2.SCL; also elsewhere on the board
A6: M1.20/A6 (20/A6/PWM), M2.A6; also elsewhere on the board
A7: M1.21/A7 (21/A7/PWM), M2.A7; also elsewhere on the board
A10: M1.A10, M2.A10
A11: M1.A11, M2.A11
AREF: M1.AREF, M2.AREF; also elsewhere on the board
D0/MOSI1: M2.D0, R1.1; also elsewhere on the board
D1/MISO1: M2.D1, R2.1; also elsewhere on the board
D2: M2.D2, R3.1; also elsewhere on the board
D3: M2.D3, R4.1; also elsewhere on the board
D4: M2.D4, R5.1; also elsewhere on the board
D5: M2.D5, R6.1; also elsewhere on the board
D6: M2.D6, R7.1; also elsewhere on the board
D7/RX3: M2.D7, M2.D17, R8.1; also elsewhere on the board
D8/TX3: M2.D8, M2.D16, R9.1; also elsewhere on the board
D9/RX2: M2.D9, M2.D19, R10.1; also elsewhere on the board
D10/TX2: M2.D10, M2.D18, R11.1; also elsewhere on the board
D11/MOSI: M2.D11, M2.MOSI, R12.1; also elsewhere on the board
D12/MISO: M2.D12, M2.MISO, R13.1; also elsewhere on the board
D13/SCK: M2.D13, M2.SCK, R14.1; also elsewhere on the board
D22/A8: M1.22/A8 (22/A8/T/PWM), M2.A8; also elsewhere on the board
D23/A9: M1.23/A9 (23/A9/T/PWM), M2.A9; also elsewhere on the board
D24: M1.24, M2.D24; also elsewhere on the board
D25: M1.25, M2.D25; also elsewhere on the board
D26: M1.26, M2.D26; also elsewhere on the board
D27: M1.27, M2.D27; also elsewhere on the board
D28: M1.28, M2.D28; also elsewhere on the board
D29: M1.29 (29/T/PWM), M2.D29; also elsewhere on the board
D30: M1.30 (30/T/PWM), M2.D30; also elsewhere on the board
D31/A12/RX4/CS1: M1.31/A12 (31/A12/RX4), M2.A12, M2.D15, M2.D31; also elsewhere on the board
D32/A13/TX4/SCK1: M1.32/A13 (32/A13/TX4), M2.A13, M2.D14, M2.D32; also elsewhere on the board
D33/A14: M1.33/A14 (33/A14/TX5/CAN1-TX), M2.A14, M2.D33; also elsewhere on the board
D34/A15: M1.34/A15 (34/A15/RX5/CAN1-RX), M2.A15, M2.D34; also elsewhere on the board
D35: M1.35/A16 (35/A16/PWM), M2.D35; also elsewhere on the board
D36: M1.36/A17 (36/A17/PWM), M2.D36; also elsewhere on the board
D37/SCL1: M1.37/A18 (37/A18/SCL1/PWM), M2.D21, M2.D37; also elsewhere on the board
D38/SDA1: M1.38/A19 (38/A19/SDA1/PWM), M2.D20, M2.D38; also elsewhere on the board
D39: M1.39/A20, M2.D39; also elsewhere on the board
D40: M1.40, M2.D40; also elsewhere on the board
D41: M1.41, M2.D41; also elsewhere on the board
D42: M1.42, M2.D42; also elsewhere on the board
D43: M1.43, M2.D43; also elsewhere on the board
D44: M1.44 (MOSI2/44), M2.D44; also elsewhere on the board
D45: M1.45 (MISO2/45), M2.D45; also elsewhere on the board
D46: M1.46 (SCK2/46), M2.D46; also elsewhere on the board
D47: M1.47 (RX6/47), M2.D47; also elsewhere on the board
D48: M1.48 (TX6/48), M2.D48; also elsewhere on the board
D49: M1.49 (A23/49), M2.D49; also elsewhere on the board
D50: M1.50 (A24/50), M2.D50; also elsewhere on the board
D51: M1.51, M2.D51; also elsewhere on the board
D52: M1.52, M2.D52; also elsewhere on the board
D53: M1.53, M2.D53; also elsewhere on the board
DAC0: M1.A21 (A21/DAC0), M2.D22; also elsewhere on the board
DAC1: M1.A22 (A22/DAC1), M2.D23; also elsewhere on the board
DC: J3.2, M1.DC
DD: J3.4, M1.DD
DE: J3.3, M1.DE
GND: C2.2, C3.2, C5.1, C6.1, C7.1, C8.1, C9.2, C10.1, D16.2 (A), IC1.4 (GND), IC2.2 (GND), IC2.3 (CTL), J1.1, J2.1, J4.2 (SLEEVE), J5.4 (GND), J5.5 (SH), J5.6 (SH), M1.GND, M1.GND1 (GND), M1.GND2 (GND), M1.GND3 (GND), M1.GND4 (GND), M1.GND5 (GND), M1.GND6 (GND), M2.GND@1 (GND), M2.GND@2 (GND), M2.GND@3 (GND), M2.GND@4 (GND), M2.GND@5 (GND), R16.2, R17.2, SW1.3, SW1.4; also elsewhere on the board
GND_A: M1.AGND, M2.AGND; also elsewhere on the board
unnamed: D1.2 (A), M1.VUSB
unnamed: C9.1, IC2.1 (IN), J5.1 (VBUS)
unnamed: IC2.4 (STAT), R18.2
unnamed: J1.2, M1.VBAT
unnamed: F1.1, J4.1 (CENTER)
unnamed: C4.2, C5.2, C6.2, C7.2, C8.2, D2.2 (A), L1.2, R15.2
unnamed: F1.2, Q1.5 (D), Q1.6 (D), Q1.7 (D), Q1.8 (D), Q1.9 (D), Q1.10 (D), Q1.11 (D)
unnamed: D3.1 (K), Q1.4 (G), R16.1
unnamed: C1.2, IC1.5 (SW), L1.1
unnamed: C4.1, IC1.1 (FB), R15.1, R17.1
unnamed: C1.1, IC1.6 (BST)
unnamed: M1.13 (13/SCK0/LED), R14.2
unnamed: M1.0 (0/RX1/MOSI1/T), R1.2
unnamed: M1.1 (1/TX1/MISO1/T), R2.2
unnamed: M1.2 (2/PWM), R3.2
unnamed: M1.3 (3/CAN0-TX/SCL2/PWM), R4.2
unnamed: M1.4 (4/CAN0-RX/SDA2/PWM), R5.2
unnamed: M1.5 (5/PWM), R6.2
unnamed: M1.6 (6/PWM), R7.2
unnamed: M1.7 (7/RX3/PWM), R8.2
unnamed: M1.8 (8/TX3/PWM), R9.2
unnamed: M1.9 (9/RX2/PWM), R10.2
unnamed: M1.10 (10/TX2/PWM), R11.2
unnamed: M1.11 (11/MOSI0), R12.2
unnamed: M1.12 (12/MISO0), R13.2
PGM: M1.PGM, M2.RESET_ICSP (RST)
RESET: J3.1, M1.RESET, M2.RESET (/RESET), R162.1, SW1.1, SW1.2; also elsewhere on the board
SCL3/57: M1.57 (SCL3/57); also elsewhere on the board
SDA3/56: M1.56 (SDA3/56); also elsewhere on the board
USB0+: J5.3 (D+), M1.USB0+
USB0-: J5.2 (D-), M1.USB0-
VUSB1: M1.VUSB1

Notes on the sheet:
BATTERY 3V Button
RESET
VPWR (8 to 24V)

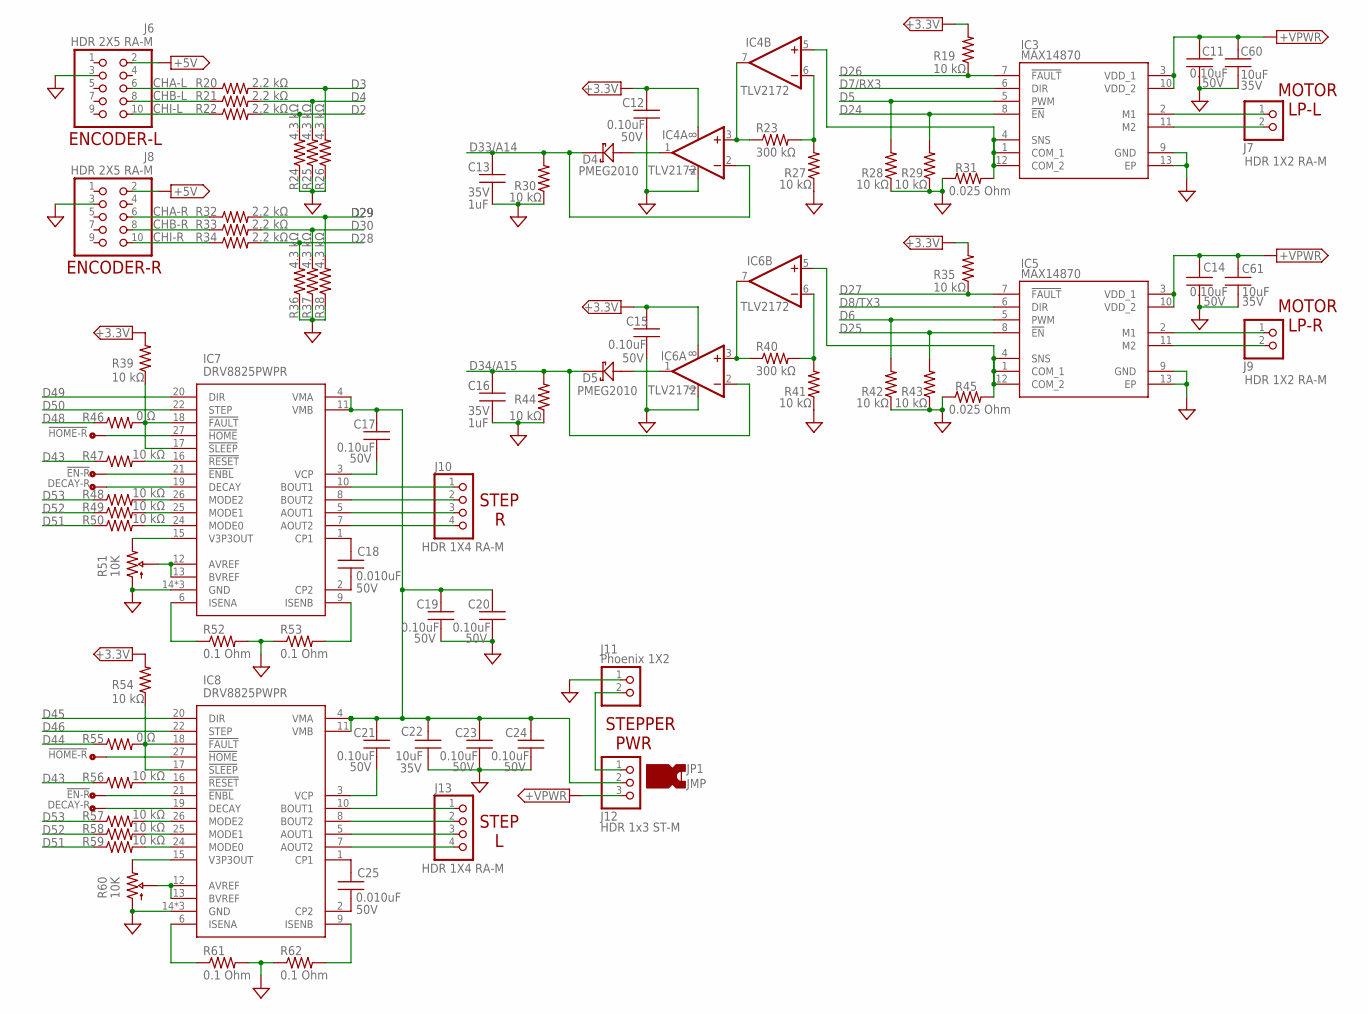
[picture p15: schematic TeenScience-RevB3.sch, sheet 2]

Parts:
C11, C12, C14, C15, C17, C19, C20, C21, C23, C24: 0.10uF; MLCC_0603
C13, C16: 1uF; MLCC_0603
C18, C25: 0.010uF; MLCC_0603
C22, C60, C61: 10uF; MLCC_1206
D4, D5: PMEG2010; SOD-123FL
IC3, IC5: MAX14870; TDFN12-EP
IC4, IC6: TLV2172; VSSOP8-DGK-065P
IC7, IC8: DRV8825PWPR; TSSOP28-PWR
J6, J8: HDR 2X5 RA-M; HDR_2X5M_RAS
J7, J9: HDR 1X2 RA-M; HDR_1X2RAS
J10, J13: HDR 1X4 RA-M; HDR_1X4RAS
J11: Phoenix 1X2; TE_282834-2_PHOENIX2
J12: HDR 1x3 ST-M; HDR_1X3
R19, R27, R28, R29, R30, R35, R39, R41, R42, R43, R44, R47, R48, R49, R50, R54, R56, R57, R58, R59: 10 kΩ; R0603
R20, R21, R22, R32, R33, R34: 2.2 kΩ; R0603
R23, R40: 300 kΩ; R0603
R24, R25, R26, R36, R37, R38: 4.3 kΩ; R0603
R31, R45: 0.025 Ohm; R1206
R46, R55: 0 Ω; R0603
R51, R60: 10K; SM-4.5X4.5-TRIM
R52, R53, R61, R62: 0.1 Ohm; R1210
TP1, TP4: !HOME-R; SMT_TEST
TP2, TP5: !EN-R; SMT_TEST
TP3, TP6: DECAY-R; SMT_TEST

Connections:
+3.3V: C12.2, C15.2, IC4.8 (V+), IC6.8 (V+), R19.2, R35.2, R39.2, R54.2; also elsewhere on the board
+5V: J6.2, J8.2; also elsewhere on the board
+VPWR: C11.2, C14.2, C60.1, C61.1, IC3.3 (VDD_1), IC3.10 (VDD_2), IC5.3 (VDD_1), IC5.10 (VDD_2), J12.3; also elsewhere on the board
CHA-L: J6.6, R20.1
CHA-R: J8.6, R32.1
CHB-L: J6.8, R21.1
CHB-R: J8.8, R33.1
CHI-L: J6.10, R22.1
CHI-R: J8.10, R34.1
D2: R22.2, R24.2; also elsewhere on the board
D3: R20.2, R26.2; also elsewhere on the board
D4: R21.2, R25.2; also elsewhere on the board
D5: IC3.5 (PWM), R28.2; also elsewhere on the board
D6: IC5.5 (PWM), R42.2; also elsewhere on the board
D7/RX3: IC3.6 (DIR); also elsewhere on the board
D8/TX3: IC5.6 (DIR); also elsewhere on the board
D24: IC3.8 (!EN), R29.2; also elsewhere on the board
D25: IC5.8 (!EN), R43.2; also elsewhere on the board
D26: IC3.7 (!FAULT), R19.1; also elsewhere on the board
D27: IC5.7 (!FAULT), R35.1; also elsewhere on the board
D28: R34.2, R36.2; also elsewhere on the board
D29: R32.2, R38.2; also elsewhere on the board
D30: R33.2, R37.2; also elsewhere on the board
D33/A14: C13.2, D4.1 (K), IC4.2 (-IN), R30.2; also elsewhere on the board
D34/A15: C16.2, D5.1 (K), IC6.2 (-IN), R44.2; also elsewhere on the board
D43: R47.1, R56.1; also elsewhere on the board
D44: R55.1; also elsewhere on the board
D45: IC8.20 (DIR); also elsewhere on the board
D46: IC8.22 (STEP); also elsewhere on the board
D48: R46.1; also elsewhere on the board
D49: IC7.20 (DIR); also elsewhere on the board
D50: IC7.22 (STEP); also elsewhere on the board
D51: R50.1, R59.1; also elsewhere on the board
D52: R49.1, R58.1; also elsewhere on the board
D53: R48.1, R57.1; also elsewhere on the board
GND: C11.1, C12.1, C13.1, C14.1, C15.1, C16.1, C19.1, C20.1, C22.1, C23.1, C24.1, C60.2, C61.2, IC3.9 (GND), IC3.13 (EP), IC4.4 (V-), IC5.9 (GND), IC5.13 (EP), IC6.4 (V-), IC7.14 (GND), IC7.28 (GND), IC7.29 (GND), IC8.14 (GND), IC8.28 (GND), IC8.29 (GND), J6.3, J8.3, J11.1, R24.1, R25.1, R26.1, R27.1, R28.1, R29.1, R30.1, R31.1, R36.1, R37.1, R38.1, R41.1, R42.1, R43.1, R44.1, R45.1, R51.3 (START), R52.2, R53.1, R60.3 (START), R61.2, R62.1; also elsewhere on the board
unnamed: IC5.2 (M1), J9.1
unnamed: IC5.11 (M2), J9.2
unnamed: D5.2 (A), IC6.1 (OUT)
unnamed: IC6.6 (-IN), R40.2, R41.2
unnamed: IC5.1 (COM_1), IC5.4 (SNS), IC5.12 (COM_2), IC6.5 (+IN), R45.2
unnamed: IC3.2 (M1), J7.1
unnamed: IC6.3 (+IN), IC6.7 (OUT), R40.1
unnamed: IC3.11 (M2), J7.2
unnamed: IC3.1 (COM_1), IC3.4 (SNS), IC3.12 (COM_2), IC4.5 (+IN), R31.2
unnamed: D4.2 (A), IC4.1 (OUT)
unnamed: IC4.6 (-IN), R23.2, R27.2
unnamed: IC4.3 (+IN), IC4.7 (OUT), R23.1
unnamed: J11.2, J12.1
unnamed: IC8.15 (V3P3OUT), R60.1 (END)
unnamed: IC8.12 (AVREF), IC8.13 (BVREF), R60.2 (WIPER)
unnamed: IC8.6 (ISENA), R61.1
unnamed: C21.1, IC8.3 (VCP)
unnamed: IC8.9 (ISENB), R62.2
unnamed: C25.1, IC8.2 (CP2)
unnamed: C25.2, IC8.1 (CP1)
unnamed: IC8.10 (BOUT1), J13.1
unnamed: IC8.8 (BOUT2), J13.2
unnamed: IC8.5 (AOUT1), J13.3
unnamed: IC8.7 (AOUT2), J13.4
unnamed: IC8.27 (!HOME), TP1.NC1, TP1.NC2, TP1.NC3, TP1.TP
unnamed: IC8.24 (MODE0), R59.2
unnamed: IC8.25 (MODE1), R58.2
unnamed: IC8.26 (MODE2), R57.2
unnamed: C17.2, C19.2, C20.2, C21.2, C22.2, C23.2, C24.2, IC7.4 (VMA), IC7.11 (VMB), IC8.4 (VMA), IC8.11 (VMB), J12.2
unnamed: IC7.12 (AVREF), IC7.13 (BVREF), R51.2 (WIPER)
unnamed: IC7.6 (ISENA), R52.1
unnamed: IC8.17 (!SLEEP), IC8.18 (!FAULT), R54.1, R55.2
unnamed: IC7.9 (ISENB), R53.2
unnamed: C18.1, IC7.2 (CP2)
unnamed: C18.2, IC7.1 (CP1)
unnamed: IC7.15 (V3P3OUT), R51.1 (END)
unnamed: IC8.19 (DECAY), TP3.NC1, TP3.NC2, TP3.NC3, TP3.TP
unnamed: IC8.21 (!ENBL), TP2.NC1, TP2.NC2, TP2.NC3, TP2.TP
unnamed: IC8.16 (!RESET), R56.2
unnamed: C17.1, IC7.3 (VCP)
unnamed: IC7.10 (BOUT1), J10.1
unnamed: IC7.8 (BOUT2), J10.2
unnamed: IC7.5 (AOUT1), J10.3
unnamed: IC7.7 (AOUT2), J10.4
unnamed: IC7.27 (!HOME), TP4.NC1, TP4.NC2, TP4.NC3, TP4.TP
unnamed: IC7.24 (MODE0), R50.2
unnamed: IC7.25 (MODE1), R49.2
unnamed: IC7.26 (MODE2), R48.2
unnamed: IC7.17 (!SLEEP), IC7.18 (!FAULT), R39.1, R46.2
unnamed: IC7.19 (DECAY), TP6.NC1, TP6.NC2, TP6.NC3, TP6.TP
unnamed: IC7.21 (!ENBL), TP5.NC1, TP5.NC2, TP5.NC3, TP5.TP
unnamed: IC7.16 (!RESET), R47.2

Notes on the sheet:
MOTOR LP-R
ENCODER-L
ENCODER-R
MOTOR LP-L
STEPPER PWR
STEP R
STEP L

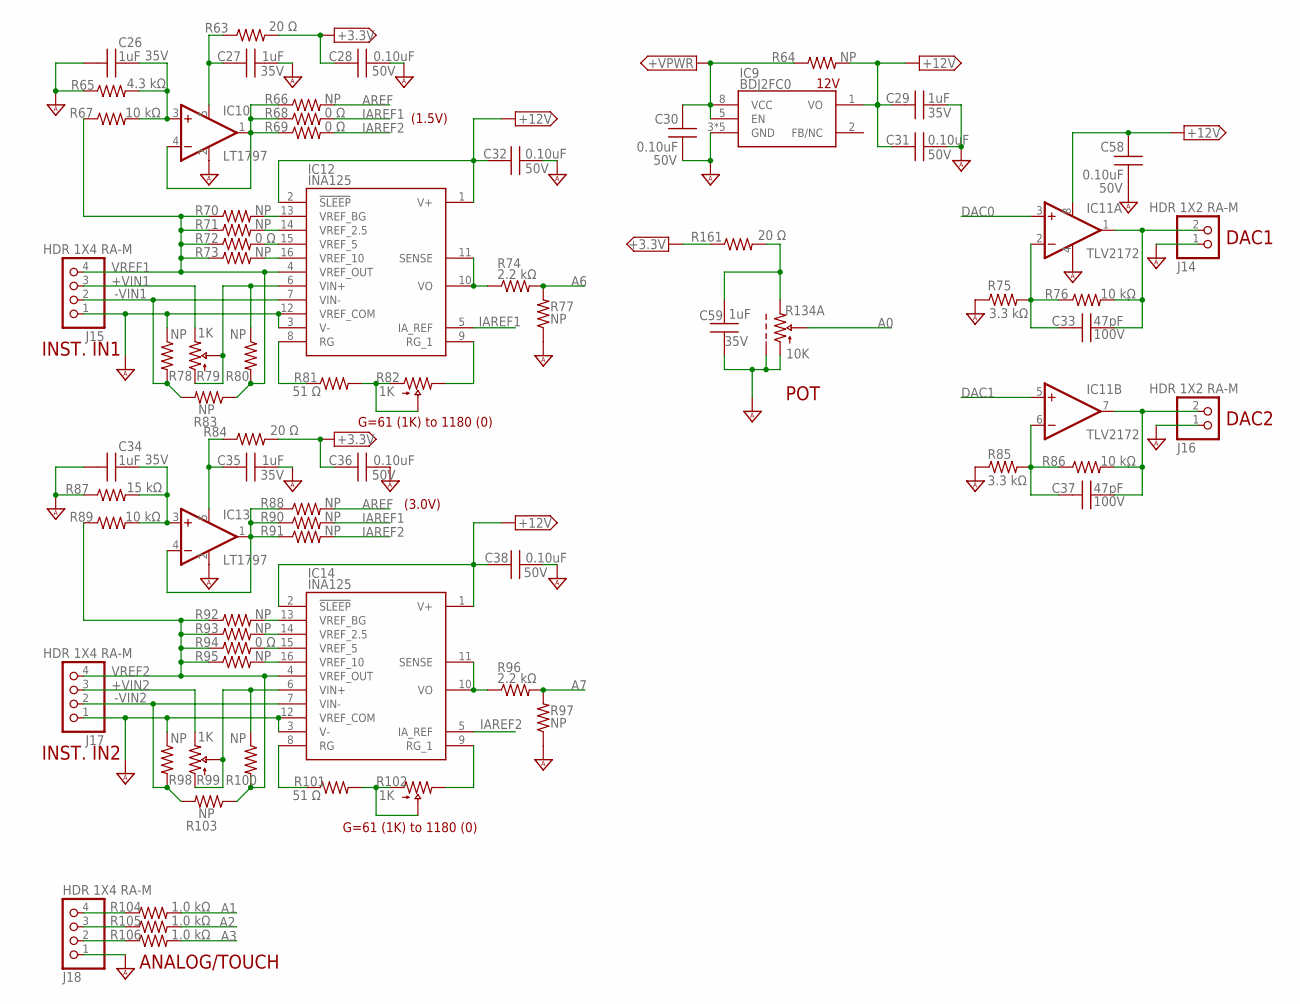
[picture p16: schematic TeenScience-RevB3.sch, sheet 3]

Parts:
C26, C27, C29, C34, C35, C59: 1uF; MLCC_0603
C28, C30, C31, C32, C36, C38, C58: 0.10uF; MLCC_0603
C33, C37: 47pF; MLCC_0603
IC9: BDJ2FC0; SOIC8-PAD127P600X100
IC10, IC13: LT1797; SOT23-5
IC11: TLV2172; VSSOP8-DGK-065P
IC12, IC14: INA125; SOIC16-127P600X175
J14, J16: HDR 1X2 RA-M; HDR_1X2RAS
J15, J17, J18: HDR 1X4 RA-M; HDR_1X4RAS
R63, R84, R161: 20 Ω; R0603
R64, R66, R70, R71, R73, R77, R78, R80, R83, R88, R90, R91, R92, R93, R95, R97, R98, R100, R103: NP; R0603
R65: 4.3 kΩ; R0603
R67, R76, R86, R89: 10 kΩ; R0603
R68, R69, R72, R94: 0 Ω; R0603
R74, R96: 2.2 kΩ; R0603
R75, R85: 3.3 kΩ; R0603
R79, R82, R99, R102: 1K; PV36YTRIMMER
R81, R101: 51 Ω; R0603
R87: 15 kΩ; R0603
R104, R105, R106: 1.0 kΩ; R0603
R134: 10K; RK09-ALPS-VERT-POT

Connections:
+3.3V: C28.2, C36.2, R63.2, R84.2, R161.1; also elsewhere on the board
+12V: C29.1, C31.2, C32.2, C38.2, C58.2, IC9.1 (VO), IC11.8 (V+), IC12.1 (V+), IC12.2 (!SLEEP), IC14.1 (V+), IC14.2 (!SLEEP), R64.2
+VIINDIR1: IC12.6 (VIN+), R79.1 (START), R79.2 (WIPER), R80.1
+VIINDIR2: IC14.6 (VIN+), R99.1 (START), R99.2 (WIPER), R100.1
+VIN1: J15.3, R79.3 (END)
+VIN2: J17.3, R99.3 (END)
+VPWR: C30.2, IC9.5 (EN), IC9.8 (VCC), R64.1; also elsewhere on the board
-VIN1: IC12.7 (VIN-), J15.2, R78.2, R83.2
-VIN2: IC14.7 (VIN-), J17.2, R98.2, R103.2
A0: R134.2 (WIPER); also elsewhere on the board
A1: R104.2; also elsewhere on the board
A2: R105.2; also elsewhere on the board
A3: R106.2; also elsewhere on the board
A6: R74.2, R77.2; also elsewhere on the board
A7: R96.2, R97.2; also elsewhere on the board
AREF: R66.2, R88.2; also elsewhere on the board
DAC0: IC11.3 (+IN); also elsewhere on the board
DAC1: IC11.5 (+IN); also elsewhere on the board
GND_A: C26.1, C27.1, C28.1, C29.2, C30.1, C31.1, C32.1, C34.1, C35.1, C36.1, C38.1, C58.1, C59.2, IC9.3 (GND), IC9.4 (GND), IC9.6 (GND), IC9.7 (GND), IC9.9 (GND), IC10.2 (V-), IC11.4 (V-), IC12.3 (V-), IC12.12 (VREF_COM), IC13.2 (V-), IC14.3 (V-), IC14.12 (VREF_COM), J14.1, J15.1, J16.1, J17.1, J18.1, R65.1, R75.1, R77.1, R78.1, R85.1, R87.1, R97.1, R98.1, R134.1 (START), R134.MH1 (SHELL), R134.MH2 (SHELL); also elsewhere on the board
IAREF1: IC12.5 (IA_REF), R68.2, R90.2
IAREF2: IC14.5 (IA_REF), R69.2, R91.2
unnamed: C27.2, IC10.5 (V+), R63.1
unnamed: C59.1, R134.3 (END), R161.2
unnamed: J18.4, R104.1
unnamed: J18.3, R105.1
unnamed: J18.2, R106.1
unnamed: IC12.10 (VO), IC12.11 (SENSE), R74.1
unnamed: IC12.13 (VREF_BG), R70.2
unnamed: C26.2, IC10.3 (+IN), R65.2, R67.2
unnamed: IC10.1 (OUT), IC10.4 (-IN), R66.1, R68.1, R69.1
unnamed: R81.2, R82.1 (START), R82.2 (WIPER)
unnamed: IC12.14 (VREF_2.5), R71.2
unnamed: IC12.15 (VREF_5), R72.2
unnamed: IC12.16 (VREF_10), R73.2
unnamed: R101.2, R102.1 (START), R102.2 (WIPER)
unnamed: IC12.8 (RG), R81.1
unnamed: IC12.9 (RG_1), R82.3 (END)
unnamed: IC14.14 (VREF_2.5), R93.2
unnamed: IC14.15 (VREF_5), R94.2
unnamed: IC14.16 (VREF_10), R95.2
unnamed: IC14.8 (RG), R101.1
unnamed: IC14.9 (RG_1), R102.3 (END)
unnamed: IC14.13 (VREF_BG), R92.2
unnamed: IC14.10 (VO), IC14.11 (SENSE), R96.1
unnamed: C34.2, IC13.3 (+IN), R87.2, R89.2
unnamed: IC13.1 (OUT), IC13.4 (-IN), R88.1, R90.1, R91.1
unnamed: C35.2, IC13.5 (V+), R84.1
unnamed: C33.1, IC11.2 (-IN), R75.2, R76.1
unnamed: C33.2, IC11.1 (OUT), J14.2, R76.2
unnamed: C37.1, IC11.6 (-IN), R85.2, R86.1
unnamed: C37.2, IC11.7 (OUT), J16.2, R86.2
VREF1: IC12.4 (VREF_OUT), J15.4, R67.1, R70.1, R71.1, R72.1, R73.1, R80.2, R83.1
VREF2: IC14.4 (VREF_OUT), J17.4, R89.1, R92.1, R93.1, R94.1, R95.1, R100.2, R103.1

Notes on the sheet:
INST. IN1
INST. IN2
(3.0V)
(1.5V)
12V
DAC1
DAC2
ANALOG/TOUCH
POT
G=61 (1K) to 1180 (0)

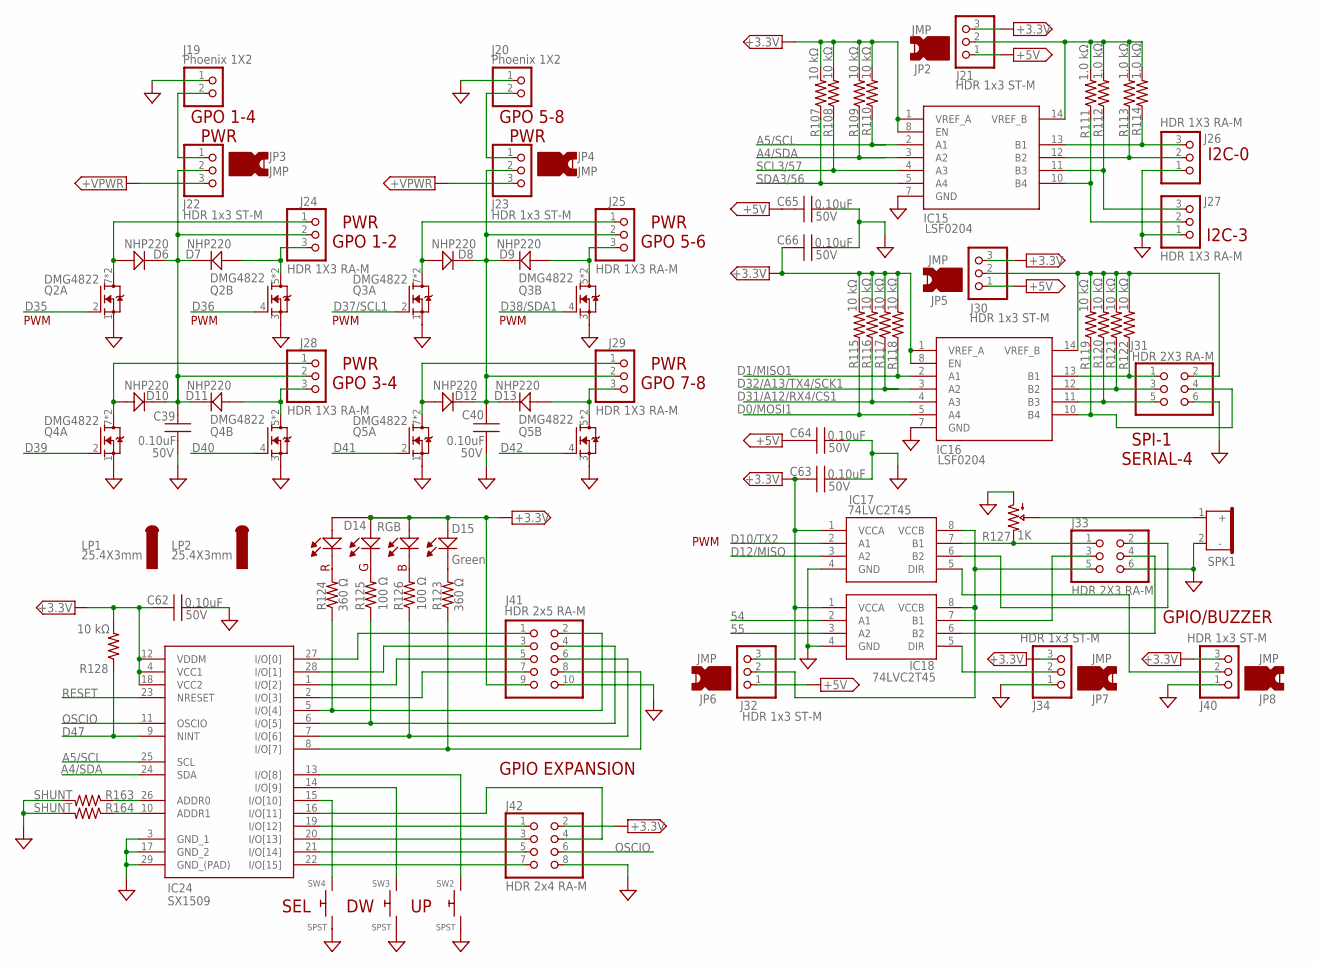
[picture p17: schematic TeenScience-RevB3.sch, sheet 4]

Parts:
C39, C40, C62, C63, C64, C65, C66: 0.10uF; MLCC_0603
D6, D7, D8, D9, D10, D11, D12, D13: NHP220; SOD-123FL
D14: RGB; SON95P2X2X1-RGB_LED
D15: Green; LED_0603
IC15, IC16: LSF0204; TSSOP14
IC17, IC18: 74LVC2T45; VSSOP8-DCU-050P
IC24: SX1509; QFN-28-4MM-0.4P-PAD
J19, J20: Phoenix 1X2; TE_282834-2_PHOENIX2
J21, J22, J23, J30, J32, J34, J40: HDR 1x3 ST-M; HDR_1X3
J24, J25, J26, J27, J28, J29: HDR 1X3 RA-M; HDR_1X3RAS
J31, J33: HDR 2X3 RA-M; HDR_2X3M_RAS
J41: HDR 2x5 RA-M; HDR_2X5M-RAHDR
J42: HDR 2x4 RA-M; HDR_2X4M-RAHDR
LP1, LP2: 25.4X3mm; EXTERNAL
Q2, Q3, Q4, Q5: DMG4822; SOIC8-127P60
R107, R108, R109, R110, R115, R116, R117, R118, R119, R120, R121, R122, R128: 10 kΩ; R0603
R111, R112, R113, R114: 1.0 kΩ; R0603
R123, R124: 360 Ω; R0603
R125, R126: 100 Ω; R0603
R127: 1K; SM-4.5X4.5-TRIM
R163, R164: SHUNT; R0603-SHORT
SPK1: CMI-9650C-120; BUZZER-5MM-12.4D
SW2, SW3, SW4: SPST; SWITCH_TAC_6MM

Connections:
1: IC15.13 (B1), J26.3, R114.1
2: IC15.12 (B2), J26.2, R113.1
3: IC16.13 (B1), J31.1, R122.1
4: IC16.12 (B2), J31.3, R121.1
54: IC18.2 (A1); also elsewhere on the board
55: IC18.3 (A2); also elsewhere on the board
+3.3V: C62.2, C63.2, C66.2, D14.1 (CA), D15.2 (A), IC15.1 (VREF_A), IC15.8 (EN), IC16.1 (VREF_A), IC16.8 (EN), IC17.1 (VCCA), IC18.1 (VCCA), IC24.4 (VCC1), IC24.12 (VDDM), IC24.18 (VCC2), J21.3, J30.3, J32.3, J34.3, J40.3, J41.9, J42.2, R107.2, R108.2, R109.2, R110.2, R115.2, R116.2, R117.2, R118.2, R128.2; also elsewhere on the board
+5V: C64.2, C65.2, J21.1, J30.1, J32.1; also elsewhere on the board
+VPWR: J22.3, J23.3; also elsewhere on the board
A4/SDA: IC15.3 (A2), IC24.24 (SDA), R109.1; also elsewhere on the board
A5/SCL: IC15.2 (A1), IC24.25 (SCL), R110.1; also elsewhere on the board
D0/MOSI1: IC16.5 (A4), R115.1; also elsewhere on the board
D1/MISO1: IC16.2 (A1), R118.1; also elsewhere on the board
D10/TX2: IC17.2 (A1); also elsewhere on the board
D12/MISO: IC17.3 (A2); also elsewhere on the board
D31/A12/RX4/CS1: IC16.4 (A3), R116.1; also elsewhere on the board
D32/A13/TX4/SCK1: IC16.3 (A2), R117.1; also elsewhere on the board
D35: Q2.2 (G); also elsewhere on the board
D36: Q2.4 (G); also elsewhere on the board
D37/SCL1: Q3.2 (G); also elsewhere on the board
D38/SDA1: Q3.4 (G); also elsewhere on the board
D39: Q4.2 (G); also elsewhere on the board
D40: Q4.4 (G); also elsewhere on the board
D41: Q5.2 (G); also elsewhere on the board
D42: Q5.4 (G); also elsewhere on the board
D47: IC24.9 (NINT), R128.1; also elsewhere on the board
GND: C39.1, C40.1, C62.1, C63.1, C64.1, C65.1, C66.1, IC15.7 (GND), IC16.7 (GND), IC17.4 (GND), IC18.4 (GND), IC24.3 (GND_1), IC24.17 (GND_2), IC24.29 (GND_(PAD)), J19.1, J20.1, J26.1, J27.1, J31.6, J33.6, J34.1, J40.1, J41.10, J42.8, Q2.1 (S), Q2.3 (S), Q3.1 (S), Q3.3 (S), Q4.1 (S), Q4.3 (S), Q5.1 (S), Q5.3 (S), R127.3 (START), R163.2, R163.P$2 (2), R164.2, R164.P$2 (2), SPK1.2 (-), SW2.1, SW2.2, SW3.1, SW3.2, SW4.1, SW4.2; also elsewhere on the board
unnamed: IC15.11 (B3), J27.3, R112.1
unnamed: IC15.10 (B4), J27.2, R111.1
unnamed: IC15.14 (VREF_B), J21.2, R111.2, R112.2, R113.2, R114.2
unnamed: D15.1 (K), R123.2
unnamed: D14.3 (G), R125.2
unnamed: IC17.5 (DIR), J40.2
unnamed: IC17.7 (B1), J33.1, R127.1 (END)
unnamed: J20.2, J23.1
unnamed: D7.2 (A), J24.3, Q2.5 (D), Q2.6 (D)
unnamed: J19.2, J22.1
unnamed: C39.2, D6.1 (K), D7.1 (K), D10.1 (K), D11.1 (K), J22.2, J24.2, J28.2
unnamed: D11.2 (A), J28.3, Q4.5 (D), Q4.6 (D)
unnamed: D10.2 (A), J28.1, Q4.7 (D), Q4.8 (D)
unnamed: D6.2 (A), J24.1, Q2.7 (D), Q2.8 (D)
unnamed: C40.2, D8.1 (K), D9.1 (K), D12.1 (K), D13.1 (K), J23.2, J25.2, J29.2
unnamed: D13.2 (A), J29.3, Q5.5 (D), Q5.6 (D)
unnamed: D12.2 (A), J29.1, Q5.7 (D), Q5.8 (D)
unnamed: D9.2 (A), J25.3, Q3.5 (D), Q3.6 (D)
unnamed: D8.2 (A), J25.1, Q3.7 (D), Q3.8 (D)
unnamed: IC16.10 (B4), J31.4, R119.1
unnamed: IC16.11 (B3), J31.5, R120.1
unnamed: IC16.14 (VREF_B), J30.2, J31.2, R119.2, R120.2, R121.2, R122.2
unnamed: D14.4 (R), R124.2
unnamed: D14.2 (B), R126.2
unnamed: IC24.5 (I/O[4]), J41.2, R124.1
unnamed: IC24.6 (I/O[5]), J41.4, R125.1
unnamed: IC24.7 (I/O[6]), J41.6, R126.1
unnamed: IC24.8 (I/O[7]), J41.8, R123.1
unnamed: IC24.13 (I/O[8]), SW2.3, SW2.4
unnamed: IC24.14 (I/O[9]), SW3.3, SW3.4
unnamed: IC24.15 (I/O[10]), SW4.3, SW4.4
unnamed: IC17.6 (B2), J33.2
unnamed: R127.2 (WIPER), SPK1.1 (+)
unnamed: IC18.5 (DIR), J34.2
unnamed: IC18.7 (B1), J33.3
unnamed: IC18.6 (B2), J33.4
unnamed: IC24.27 (I/O[0]), J41.1
unnamed: IC17.8 (VCCB), IC18.8 (VCCB), J32.2, J33.5
unnamed: IC24.28 (I/O[1]), J41.3
unnamed: IC24.1 (I/O[2]), J41.5
unnamed: IC24.2 (I/O[3]), J41.7
unnamed: IC24.19 (I/O[12]), J42.1
unnamed: IC24.20 (I/O[13]), J42.3
unnamed: IC24.16 (I/O[11]), J42.4
unnamed: IC24.21 (I/O[14]), J42.5
unnamed: IC24.22 (I/O[15]), J42.7
unnamed: IC24.26 (ADDR0), R163.1, R163.P$1 (1)
unnamed: IC24.10 (ADDR1), R164.1, R164.P$1 (1)
OSCIO: IC24.11 (OSCIO), J42.6
RESET: IC24.23 (NRESET); also elsewhere on the board
SCL3/57: IC15.4 (A3), R108.1; also elsewhere on the board
SDA3/56: IC15.5 (A4), R107.1; also elsewhere on the board

Notes on the sheet:
SPI-1 SERIAL-4
GPO 1-4 PWR
GPO 5-8 PWR
PWR GPO 1-2
PWR GPO 3-4
PWR GPO 5-6
PWR GPO 7-8
I2C-3
I2C-0
GPIO/BUZZER
PWM
SEL
GPIO EXPANSION

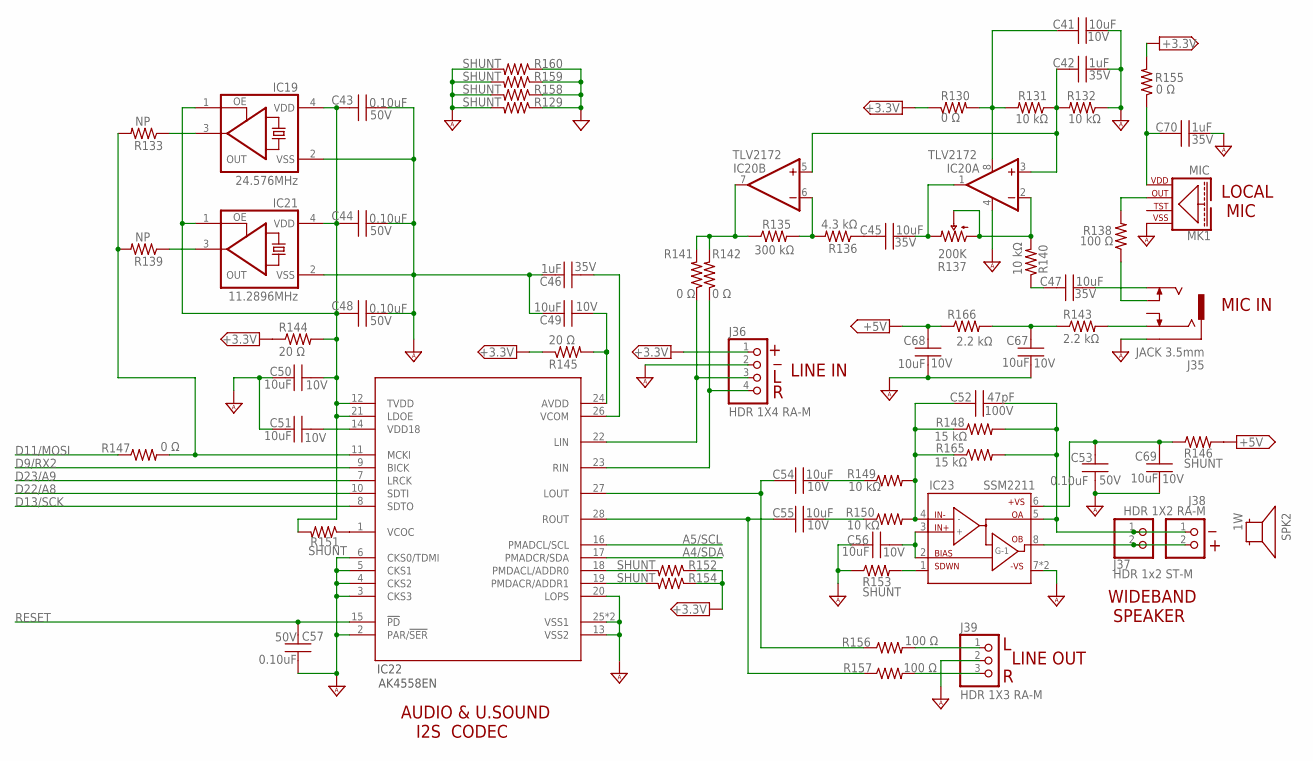
[picture p18: schematic TeenScience-RevB3.sch, sheet 5]

Parts:
C41, C49, C50, C51, C54, C55, C56, C67, C68, C69: 10uF; MLCC_0603
C42, C46, C70: 1uF; MLCC_0603
C43, C44, C48, C53, C57: 0.10uF; MLCC_0603
C45, C47: 10uF; MLCC_1206
C52: 47pF; MLCC_0603
IC19: 24.576MHz; 2.5X2-4-PAD
IC20: TLV2172; VSSOP8-DGK-065P
IC21: 11.2896MHz; 2.5X2-4-PAD
IC22: AK4558EN; QFN-28-5MM-0.5P-PAD
IC23: SSM2211; LFCSP8_3X3
J35: JACK 3.5mm; AUDIO-JACK-SJ1-3533NS
J36: HDR 1X4 RA-M; HDR_1X4RAS
J37: HDR 1x2 ST-M; HDR_1X2
J38: HDR 1X2 RA-M; HDR_1X2RAS
J39: HDR 1X3 RA-M; HDR_1X3RAS
MK1: MIC; SPH6611_MEMS_2.65X3.50
R129, R146, R151, R152, R153, R154, R158, R159, R160: SHUNT; R0603-SHORT
R130, R141, R142, R147, R155: 0 Ω; R0603
R131, R132, R140, R149, R150: 10 kΩ; R0603
R133, R139: NP; R0603
R135: 300 kΩ; R0603
R136: 4.3 kΩ; R0603
R137: 200K; SM-4.5X4.5-TRIM
R138, R156, R157: 100 Ω; R0603
R143, R166: 2.2 kΩ; R0603
R144, R145: 20 Ω; R0603
R148, R165: 15 kΩ; R0603
SPK2: 1W; EXTERNAL

Connections:
+3.3V: J36.1, R130.1, R144.1, R145.1, R152.1, R152.P$1 (1), R154.1, R154.P$1 (1), R155.2; also elsewhere on the board
+5V: C68.2, R146.2, R146.P$2 (2), R166.1; also elsewhere on the board
A4/SDA: IC22.17 (PMADCR/SDA); also elsewhere on the board
A5/SCL: IC22.16 (PMADCL/SCL); also elsewhere on the board
D9/RX2: IC22.9 (BICK); also elsewhere on the board
D11/MOSI: R147.1; also elsewhere on the board
D13/SCK: IC22.8 (SDTO); also elsewhere on the board
D22/A8: IC22.10 (SDTI); also elsewhere on the board
D23/A9: IC22.7 (LRCK); also elsewhere on the board
GND: R129.1, R129.P$1 (1), R158.1, R158.P$1 (1), R159.1, R159.P$1 (1), R160.1, R160.P$1 (1); also elsewhere on the board
GND_A: C41.2, C42.2, C43.1, C44.1, C46.2, C48.1, C49.2, C50.2, C51.2, C53.2, C56.1, C57.1, C67.1, C68.1, C69.1, C70.2, IC19.2 (VSS), IC20.4 (V-), IC21.2 (VSS), IC22.2 (PAR/!SER), IC22.3 (CKS3), IC22.4 (CKS2), IC22.5 (CKS1), IC22.6 (CKS0/TDMI), IC22.13 (VSS2), IC22.20 (LOPS), IC22.25 (VSS1), IC22.29 (VSS1), IC23.7 (-VS), IC23.EXP (-VS), J35.1 (SLEEVE), J36.2, J39.2, MK1.2 (VSS), MK1.3 (VSS), R129.2, R129.P$2 (2), R132.1, R153.1, R153.P$1 (1), R158.2, R158.P$2 (2), R159.2, R159.P$2 (2), R160.2, R160.P$2 (2); also elsewhere on the board
unnamed: IC23.8 (OUTB), J37.2, J38.2
unnamed: C46.1, IC22.26 (VCOM)
unnamed: C49.1, IC22.24 (AVDD), R145.2
unnamed: C43.2, C44.2, C48.2, C50.1, IC19.1 (CON), IC19.4 (VDD), IC21.1 (CON), IC21.4 (VDD), IC22.12 (TVDD), IC22.21 (LDOE), R144.2, R151.2, R151.P$2 (2)
unnamed: C51.1, IC22.14 (VDD18)
unnamed: IC22.1 (VCOC), R151.1, R151.P$1 (1)
unnamed: C70.1, MK1.5 (VDD), R155.1
unnamed: IC23.1 (SDWN), R153.2, R153.P$2 (2)
unnamed: C56.2, IC23.2 (BIAS), IC23.3 (IN+)
unnamed: C52.2, IC23.5 (OUTA), J37.1, J38.1, R148.2, R165.2
unnamed: C52.1, IC23.4 (IN-), R148.1, R149.2, R150.2, R165.1
unnamed: IC22.11 (MCKI), R133.2, R139.2, R147.2
unnamed: IC22.18 (PMDACL/ADDR0), R152.2, R152.P$2 (2)
unnamed: IC22.19 (PMDACR/ADDR1), R154.2, R154.P$2 (2)
unnamed: C55.2, R150.1
unnamed: IC21.3 (OUT), R139.1
unnamed: IC19.3 (OUT), R133.1
unnamed: C54.2, R149.1
unnamed: C55.1, IC22.28 (ROUT), R157.1
unnamed: C54.1, IC22.27 (LOUT), R156.1
unnamed: C53.1, C69.2, IC23.6 (+VS), R146.1, R146.P$1 (1)
unnamed: J39.3, R157.2
unnamed: J39.1, R156.2
unnamed: C47.1, R140.1
unnamed: IC22.23 (RIN), J36.4, R142.1
unnamed: IC22.22 (LIN), J36.3, R141.1
unnamed: C47.2, J35.2 (TIP)
unnamed: IC20.2 (-IN), R137.2 (WIPER), R137.3 (START), R140.2
unnamed: C45.1, R136.1
unnamed: C45.2, IC20.1 (OUT), R137.1 (END)
unnamed: IC20.6 (-IN), R135.2, R136.2
unnamed: IC20.7 (OUT), R135.1, R141.2, R142.2
unnamed: C41.1, IC20.8 (V+), R130.2, R131.2
unnamed: C42.1, IC20.3 (+IN), IC20.5 (+IN), R131.1, R132.2
unnamed: J35.4 (SW_TIP), R138.1
unnamed: J35.3 (RING), R143.2
unnamed: MK1.1 (OUT), R138.2
unnamed: C67.2, R143.1, R166.2
RESET: C57.2, IC22.15 (!PD); also elsewhere on the board

Notes on the sheet:
AUDIO & U.SOUND I2S CODEC
WIDEBAND SPEAKER
LINE OUT
LINE IN
MIC IN
LOCAL MIC
