Columbia-University-ZMBBI-AIC/Teenscience/Hardware/TeenScience-RevB3.brd

## EAGLE design Hardware/TeenScience-RevB3.brd (continued)

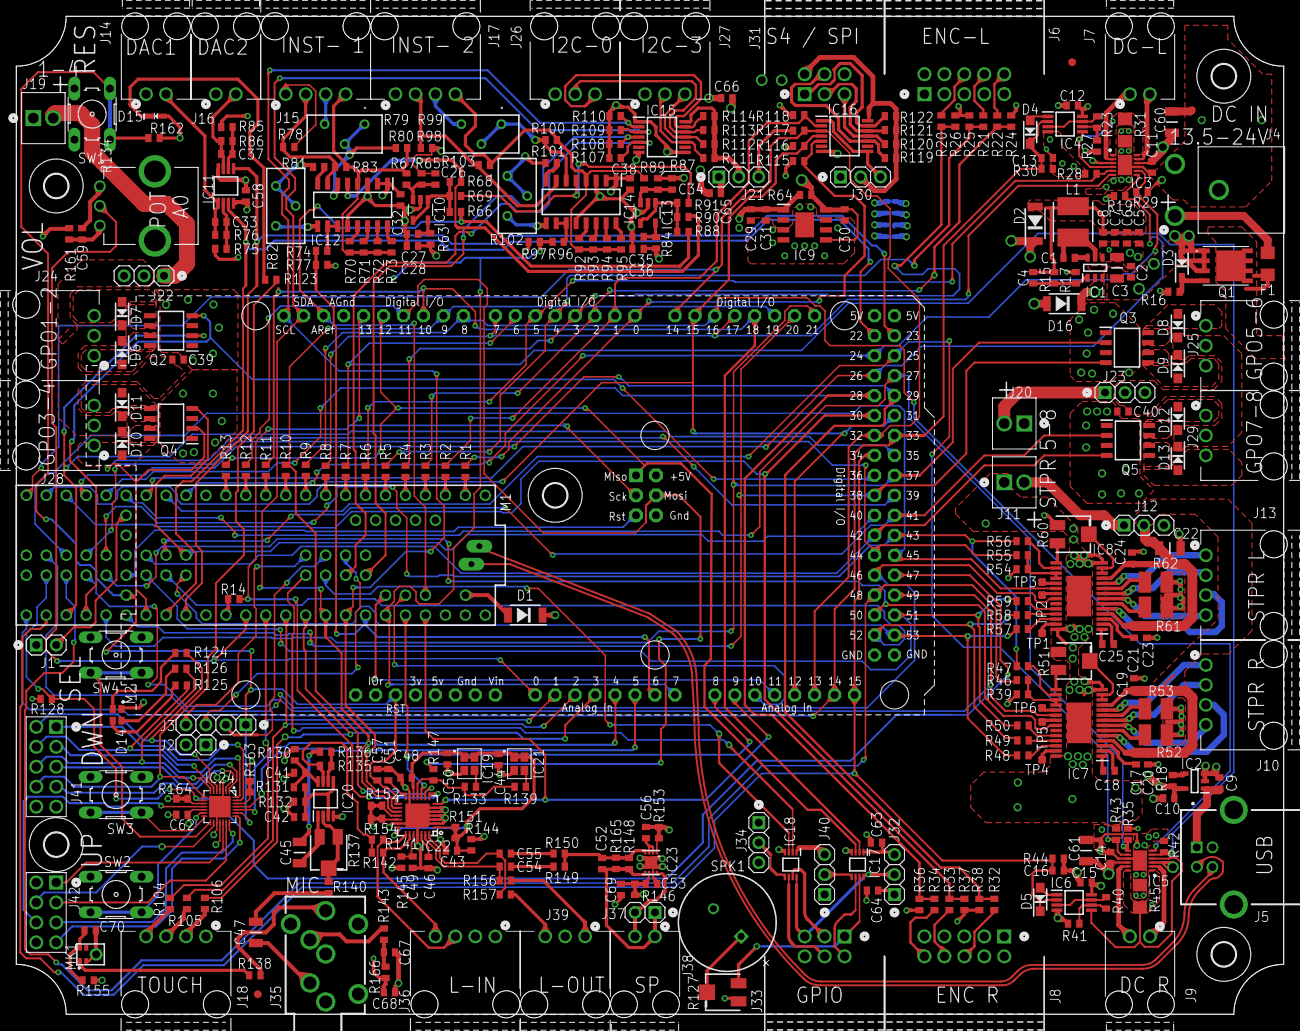
[picture p19: board TeenScience-RevB3.brd from above]

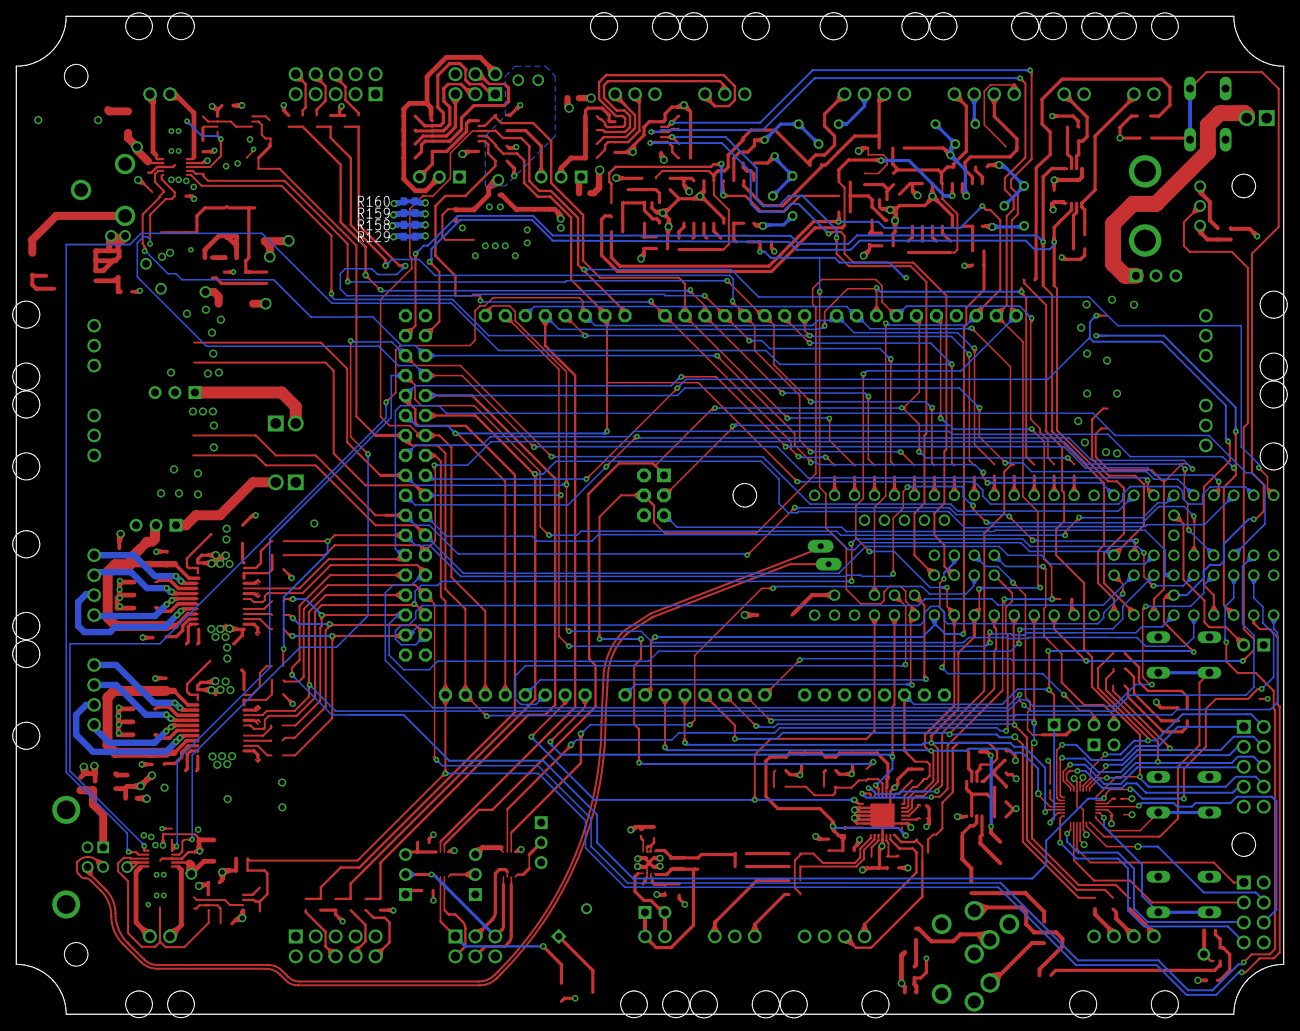
[picture p20: board TeenScience-RevB3.brd from below]

Board: 4 copper layers, 161.3 x 127.0 mm, 349 parts (4 on the bottom side), 290 nets.

Other parts of the board:
U$1, U$2, U$4, U$5, U$7: 3,0
